Morechips/yuntong-smart-glasses/3D打印文件/ArcMask_后枕托穿带修正_20261101/README.md

# 后枕托穿带修正：单件补打

> 提交版只附完成后的结构模型、打印文件、图示和说明；本目录原说明中提及的生成脚本与参数文件不随包附带。

2026-11-01后续更正：用户看过候选后要求继续建；本轮沿用25mm带宽/单层≤2.5mm的设计假设，输出**单盘一件3MF并完成离线切片**，不再停在仅候选图阶段。带厚没有新增实测，真实穿带/承力仍待试装；不把用户“继续建”当作尺寸实测或适配通过。

## 本次补打文件

- [单盘一件3MF（A1 / 0.4 / PETG）](ArcMask_Rear_R01_A1_PETG_1part.3mf)
- [本体和清支撑辨认图](images/print_cleanup.png)
- [实际切片支撑路径](images/sliced_supports.png)、[首层路径](images/first_layer.png)
- [最终3MF/G-code核验](qa/project_verification.json)、[两种支撑比较](qa/support_comparison.json)

预测 **2小时1分10秒 / 20.89g**，含支撑/裙边。仅R01后枕托，不含旧件、其他壳体、织带或电池盒。实体落床包络119×51×20mm，安装柱朝上；A1/0.4喷嘴、PETG、0.2层高、4墙、20%陀螺、普通自动贴合支撑、上下间隙0.2、外裙边4mm。温度沿用既有Generic PETG档255℃/80℃、体积流量8mm³/s，未替用户发送打印。

同几何/姿态下，树状版本预测2:29:01/21.28g，普通贴合2:01:10/20.89g，选后者。两版均保留在`qa/`比较目录；支撑哪版更易拆没有实测，不能从估时或路径图宣称拆支撑效果更好。最终3MF与当前STL顶点/三角面匹配、无缩放、单盘一件无漏切/越床，实际支撑与界面路径存在。只有传统延时摄影不支持提示，不是模型悬空警告。

## 打完怎么清理

1. 冷却后取件，先去外裙边。
2. 将底部生成支撑分小块剪开清理，靠近连接处时用钳口接近界面，避免整片撬动薄弧面或以安装柱作杠杆。
3. 清空左右带槽和中间顶带槽，保留槽框。**两根电池安装柱、上下宽连接根和全部槽框都是本体**，见辨认图。
4. 先穿自由带尾并回折，再装原电池盒；孔位未改。先小幅试拉观察连接根/柱根，再试装带软垫。实际织带缝边、硬扣、折弯和粘合长度仍需实配，不强塞。

用户实物显示后枕托长带口紧靠电池安装柱，带子穿出后无法转弯。源码确认原槽内侧X44.5与柱外缘X44.2只有0.3mm；之前孔贯通检查遗漏穿出、转弯和回折路径。这是设计遗漏，不要求靠硬塞或剪安装柱解决。此前“旧佩戴件继续复用”的建议须撤回后枕托这一项。

## 查看

- [新旧局部对比](images/rear_old_new.png)
- [穿带与电池位置](images/rear_threading.png)
- [离线旋转模型](rear_strap_viewer.html)：拖动旋转，图例切换电池盒和橙色织带参考。
- [修正后枕托STEP](step_parts/R01_rear_cradle_clear_strap.step)
- [落床STL](stl_print/R01_rear_cradle_clear_strap.stl)：仅枕托一件，无织带/电池盒；与最终3MF匹配。
- [29项数字检查及参数](qa/validation.json)

## 改动与穿法

| 项目 | 旧版 | 修正候选 |
|---|---:|---:|
| 左右带耳中心X | ±48 | ±56mm |
| 槽净开口，带宽×厚度方向 | 25.8×3.6 | 26.5×6.0mm |
| 槽内侧至柱外缘，中心高度处 | 0.3 | 8.3mm |
| 含耳总宽 | 103 | 119mm |
| 主贴头曲面宽/高/球面半径 | 92/38/R120 | 保留 |
| 电池安装轴 | X±40/Z8，座面Y222 | 保留 |

两个耳各向外8mm，上下连接梁各3.75mm高、沿Y为12mm深，连到原弧面后按原软垫包络裁切；四根部均有正体积重叠。梁位于织带上下，不穿过进带通道。电池盒、前部壳体、B分体内架和旧文件不改。

自由带尾从外侧沿X穿过长槽，从槽内侧出来后在柱外侧的新空区向前转弯，围过带耳前侧横条，向原侧带方向回折粘合。左右镜像。橙色为织带占用空间，不是打印件。按25mm宽、单层最大2.5mm、中心线转弯半径3.5mm建立；半径是检查候选，不是已验证的织带弯折要求。6mm净槽不表示硬扣、缝边或整个闭合环均能穿过。

## 检查边界

29项数字检查包括：原几何重建对已交付STEP，新件单实体/有效、STEP往返、STL闭合与候选落床，左右完整U形包络及连续直线穿入通道对枕托/原电池盒的避让，原孔/工具通路、主接触壳与软垫包络保留、四根部实体重叠、旧源SHA不变。

**绑带已到，最厚缝边/魔术贴单层厚度尚未实测反馈。** 之前1.6mm及本轮2.5mm均为设计假设，已单独询问这一项，不需要重测其他元件。实际带宽、缝边/硬扣通过、折弯和粘合长度、支撑拆除/强度、软垫及佩戴均待验；`all_checks_passed=false`。

此前“暂不发布带G-code的3MF、等待厚度”的停点由本轮用户要求继续建及上述单件工程取代；实测待验并未关闭。仅该后枕托一件补打，原件不建议剪柱或削薄承力根部。不涉及打印提交或电子设备操作。

几何重建：`build_rear.py`（项目CadQuery环境）；图及查看器：`render_rear.py` / `render_cleanup.py`；工程打包/离线切片/核验：`prepare_print.py` / `slice_print.py` / `verify_print.py`；交付和记录核对：`finish_gate.py`。参数和旧源SHA在检查记录，用户实物反馈摘要在`reference/user_feedback.json`；聊天附件的原临时路径已无法读取，未伪称保存原照片。
