Morechips/yuntong-smart-glasses/3D打印文件/RDKX5_B3_v0_1_分仓计算盒_20261102/README.md

# RDK X5 B3 v0.1 · 一体双仓计算盒

> 提交版只附完成后的结构模型、打印文件、图示和说明；本目录原说明中提及的生成脚本与参数文件不随包附带。

用户于2026-11-02确认五金规格并授权建模。本版为实际可编辑CAD与单件打印网格，沿用X5上层/P23C下层、旁侧电池分仓、同一底座，DC和USB从盒外连接；未发送打印、未接线、未操作开发板。

## 查看与文件

- 新增带标注整体图与逐层分解图（原工作区参考，本包未收录），采用当前M3套筒＋M2贯穿配置；仅改变展示，制造文件不变。
- **打印入口：[A1/PETG单盘九件3MF](B3_v01_A1_PETG_9件.3mf)**。对应已接受的M3套筒临时装法，也兼容M2.5正式铜柱；两种装法复用这九件，无需热熔胶承担固定。0.20mm层高、4道墙、20%陀螺填充、按层打印、关闭自动支撑；此项由`qa/print_project_verification.json`记录最终切片与摆盘核对。
- 实际离线切片预测 **13小时7分52秒、170.46g**，一盘九件均切出，无越床或支撑路径，保留3mm物件间距；只有延时摄影兼容提示。打印时间取决于实际机器/耗材配置，这不是实打印计时。未发送打印。
- [可旋转三维模型](B3_模型查看.html)：自包含离线HTML，浏览器打开；可组装/开盖/拆分、查看底面和五金。深色/绿色/棕色仅区分零件，实际可都用现有PETG。
- [整机与内部图](images/01_整体与内部.png)、[拆分与安装顺序](images/02_拆分与顺序.png)、[背部绑带桥](images/03_背部绑带.png)、[九件认件图](images/04_九件认件.png)。均由本CAD直接渲染，非AI效果图。
- [整机STEP](B3_v01_assembly.step)：包括打印件、参考电子件和五金，**不能把整个STEP当作一个打印件**。
- [单件STL目录](stl/)已按打印方向平放，单位mm；[单件STEP目录](step/)为装配坐标下的可编辑实体。
- 参数（建模生成资料仅留原工程，本包未收录）、CAD源代码（建模生成资料仅留原工程，本包未收录）、[几何检查](qa/geometry_checks.json)、[单件清单](qa/parts_manifest.json)。

## 尺寸与结构

- 主盒体 **98×146×55mm**。九件打印结构含背桥包络约 **101×146×68mm**；正式版含螺丝头的整体约 **105×149.5×71.5mm**，外接插头/线弯和贴身软垫另计。尺寸由[交付核验](qa/delivery_checks.json)读取实体计算。
- 计算仓与电池仓共用2.4mm承重底座，中间双壁和7mm空气通路；侧壁竖槽用于通风，不作为已验证隔热或散热的结论。
- X5按官网未缩放STEP定位。安装孔中心直接取官方STEP的约3.5052/61.5052及3.4982/52.4948，孔距58×约49、孔径Ø2.5。
- P23C按65×56×1.5、孔距58×49/Ø3.1、正面11.3/背面3.4mm的保守高度区固定。插座块位置仅用于识别，两端采用宽服务窗，尚无P23C精确ECAD；不能据此宣称全部插拔已实测通过。
- 上层横框从板上方用4个M2.5×8铜柱固定X5，下方不再堆一层完整厚底板。模块先在桌上预装，再由4颗M3×10装入底座。计算盖用3颗M3，第四角由侧板上沿支承，避开横框紧固区。
- 电池实体67.4×55.2×43.5，底部留1.6mm软垫，盒体/底座承重；小挡条做侧向防滑，不能靠盖板和弹性带挤压电芯。最大高度之外还有约5mm上方软线余量；充电母头在电池侧边口袋，开盖取出。
- 20×20×7mm散热片及0.5mm导热层是空间预留，型号未选定。当前无风扇，是否够散热要实际负载装机测温。

## 五金实际用量

**M2.5铜柱未到时，用户已接受的临时方案**：用 **M3×8mm内孔贯通的双通铜柱8个＋M2×16盘头/圆柱头螺丝8颗＋M2螺母8个（对边4、厚约1.6）**。铜柱仅作间隔套，M2杆自由穿过，再由螺母锁紧；保留孔环绝缘垫。柱身8mm、对边≤5.5mm，不用M3公母柱的外螺纹穿X5孔，不扩Ø2.5原孔，也不用M2去啮合M3螺纹。需要上下对孔后轻锁，不能压PCB弯曲。实际柱长/外径、是否贯通仍以手头件为准；若不同不能直接套用。

临时方案不改九个打印件，396项数字避让已过，见[临时五金核对](qa/temporary_hardware_checks.json)。贯穿后的下层螺丝露出螺母约1.4mm，上层约1.0mm，已检查对应空间；仍需实配。原来M2.5短螺丝/铜柱只用于下面正式方案，临时方案用M2长螺丝和M2螺母替代它们。

| 项目 | 本模型用量 | 前述预备数量 |
|---|---:|---:|
| M2.5×8双通六角铜柱，对边5mm | 8 | 10 |
| M2.5×5内六角圆柱头螺丝 | 16 | 20 |
| M2.5尼龙平垫，厚0.5，外径按5.5建模 | 24 | 30 |
| M3×10内六角圆柱头螺丝 | 19 | 20 |
| M3×16同款螺丝 | 4 | 8 |
| M3普通六角螺母，对边5.5、厚2.4 | 23 | 30 |
| M3平垫，厚0.5 | 23 | 30 |

M3平垫统一按外径7mm、厚0.5mm建模，背桥头部凹位Ø8mm。螺丝长度都从头下量；M2.5/M3内六角扳手分别为2.0/2.5mm。少量细扎带或现有线绳可用于止拉，软垫沿用现有材料；没有要求购买热熔螺母或新铰链。

## 安装顺序

**当前临时装法请先看[简明图解](安装简明说明.md)**，按M2×16贯穿/顶端M2螺母锁紧；下面第2～3步为M2.5正式铜柱的装法，不能照搬成M2啮合M3。

1. 清理短孔/螺母位。先在空底座预放23颗M3普通螺母；侧板关闭后部分入口会被挡住。各孔只轻试，不用长螺丝顶底扩孔。
2. 下层：4个8mm铜柱先用4颗M2.5×5从底座背面固定，头与垫片放进凹位；再放尼龙垫、P23C、尼龙垫，用另4颗M2.5×5固定。正面大电容朝上。
3. 桌上预装上层模块：X5上表面的孔环放尼龙垫、铜柱，板下放尼龙垫和4颗M2.5×5向上拧入；横框放在铜柱上端，用另4颗M2.5×5固定。只接触安装孔周围硬区，不压元件/焊点。
4. 上层模块从顶部整体落入，用4颗M3×10固定横框。下层插头、上层SD/排线、螺丝工具操作均在盖板关闭前试摆。
5. 装左服务板4颗、右服务板2颗、前服务板2颗M3×10。左侧宽窗对应P23C输入与X5 HDMI/音频，右侧对应P23C双C和X5 USB-A/RJ45，前侧对应供电/设备C/调试/SD及排线服务。
6. 电池底垫薄软垫后放入，输出线由左侧开放U槽侧放进去，用现有线绳/细扎带轻束止拉；母头放侧边口袋，软线松弯收纳，盖合前检查不夹线。
7. 计算盖3颗、电池盖4颗M3×10最后装。外部DC公头接P23C，供电USB从P23C到X5电源C口；按实物丝印识别，不把设备C或HDMI当电源口。本模型不验收电源板双口总电流/供电兼容。
8. 两个U形背桥分别拆下、放入50mm带子，再用4颗M3×16装回。横向/纵向通道净宽54、净高6mm；尾端不必穿闭口。允许沿带长调节，实际承载、滑动和防摆需试戴；不宣称6mm通道能把4mm叠层摩擦夹死。

## 打印准备

- 现有PETG、0.4mm喷嘴可先用0.20mm层高、4道墙、4～5层顶底、15～20%填充。温度/流量沿用实验室对这卷料已跑通的预设。
- STL已放好朝向：底座平底贴板、开口朝上；三侧板的宽平面贴板；盖板/横框平放；背桥宽底朝下，两端脚朝上。**背桥与底座分体，因此无需把整个底板悬空架在四个脚上打印。**
- 当前结构以免支撑方向设计，螺母位只有短桥接。切片后仍需逐层确认，不能把CAD检查当成已完成切片；勿直接对整机STEP自动支撑打印。
- 用户后续要求简单核对并给3MF，已增加上述单盘工程。切片结果/时间以`qa/print_project_verification.json`为准，未提交打印；实际接头插拔和带子仍待试装。需要的局部适配改动只改对应侧板/横框，不重打整套。

## 核验边界与来源

数字核验包括独立打印件间、官方X5全706实体、P23C保守两面高度、电池实测外廓，以及五金/面板插头通道和上层模块竖向装入位置。实际插座外形、线根、手指可达性、螺纹咬合、PETG层间强度、带子摩擦与长期温升仍需实物核对；数字检查不是安全/承载或热性能证明。

官方来源：[下载入口](https://developer.d-robotics.cc/rdk_x_doc/Quick_start/download?p=RDK+X5&v=3.5.0)、[X5 STEP](https://archive.d-robotics.cc/downloads/hardware/rdk_x5/RDK_X5_LPDDR4_4266MHz_V1P0_pcb.stp)、[官方规格书](https://archive.d-robotics.cc/downloads/hardware/rdk_x5/d_robotics_rdk_x5_zh_v1_1.pdf)。本地原件在前期方案目录`refs/`，原始输入见实测记录（原工作区参考，本包未收录）。
