Morechips/yuntong-smart-glasses/docs/STATUS.md

# 实现状态与验证范围

整理日期：2026-11-04。以下历史实机结果来自原工程记录，本次整理没有重新操作设备。

| 内容 | 当前状态 |
|---|---|
| 地面模型 → X5 → 电脑决策 → ESP 声振 | 已在开发场景完成真实闭环，用户确认能听到 / 感到 |
| 持续演示窗口、断流清旧状态、原地址重连 | 已有软件检查与短时实机记录；未完成数小时佩戴验收 |
| PC ONNX 与 X5 BIN | 同 32 张开发图，实板类别与量化模拟像素差为 0 |
| 原始训练数据 | 六张训练图、两张同走廊开发探针；标签为粗监督 |
| 头戴结构 | 用户反馈已制作装配完成；局部强度、触感串振、热与长期舒适性待验 |
| RDK X5 B3 计算盒 | CAD / STEP / STL / 单盘 3MF 已有数字检查，实物插拔 / 承载 / 温升待验 |
| 地面＋盲道双模型联调 | 已在真实图像流完成连续运行，障碍语音与盲道振动均有回执；仍有秒级空档，佩戴左右和身体航向未验 |
| 完整导航 / 路径规划 / 测距 / 视觉 IMU 融合 | 未在当前入口实现 |

## 已有记录及其口径

| 日期与范围 | 结果 | 不能推导的结论 |
|---|---|---|
| 11-01 真实视觉声振闭环，30 秒 | 435 结果 / 561 接收，3 句音量 55 语音、3 次 500ms 短振；接收至决策 P95 98.061ms | 非曝光到反馈延迟，非独立准确率 |
| 11-01 静音持续运行，150 秒 | 2703 结果 / 2712 接收，最近 2048 结果 P95 63ms，正常结束和清理 | 全部 UNKNOWN，只验证运行与退出，不是障碍识别验收 |
| 11-02 双模型固定图，90 秒 | 1230 地面 / 238 盲道结果，地面 RPC＋决策 P95 80.66ms | 缓存图不含真实图传，不等于稳定实流 |
| 11-02 双模型真实流，60 秒 | 702 接收 / 667 地面 / 139 盲道，地面 P95 78ms；5 次 >500ms 空档，最长 1531ms | **连续性未通过**；镜头天花板、全 UNKNOWN，不验识别 |
| 11-04 双模型连续联调，182 秒 | 1084 帧接收 / 1033 地面结果 / 盲道 CONFIRMED 33，语音确认 29 次、振动确认 2 次，接收至结果 P95 96ms | 46 次 >500ms 空档、最长 3219ms；非佩戴行走验收 |

纯图传也出现超时 / 重连，部分源帧年龄保守下界超过 500ms。接收后时效不能代替源帧新鲜度，根因未定；这项问题在提交整理中没有修复。

X5 曾出现 MMC / 文件读取 I/O 错误。用户重启后暂未复现、挂载可写且 ext4 错误计数为零；不能据此称存储问题已解决。

## 双模型联调源码

`benchmarks/ground_tactile_joint_20261102/` 为地面障碍与盲道双模型联调源码，含软件测试和运行记录说明。分工为地面结果驱动障碍方位语音、盲道结果驱动图像偏位触觉。三帧确认、换源清除、障碍优先、居中不振已随联调路径实现；佩戴左右、身体航向和真实走直线验证仍未完成。运行记录中的 `runs/`、`qa/` 目录不随本包提供，相关链接指向原工作区。

本次包不附带外部盲道权重、外部校准照片和原工作区冻结清单。`paths.py` 已改为校验本包的主链路文件清单。需要自行准备合法可用的以下文件后才能尝试候选：

```text
benchmarks/blindpath-guideTWSI-x5-20260911/model/yolo11n_tactile.onnx
benchmarks/blindpath-guideTWSI-x5-20260911/model/yolo11n_tactile_bayese_640x640_nv12.bin
benchmarks/blindpath-guideTWSI-x5-20260911/calibration/teaser_0206.jpg
```

BIN 预期 SHA256：`4c5150ce17c1e09264ffbadc20a0af84733be8c5edfbc579aded69f4f47b7439`。来源与授权需要结合原项目和模型链核对，不能用本包的自有代码说明覆盖。

## 本次整理的核验

`submission/validation.json` 记录本包实际执行的文件哈希 / 路径 / JSON / Python 语法 / 文档链接 / 隐私规则检查、软件测试、真实 PC ONNX 离线推理和结构文件检查。模拟流测试只使用本机回环服务，不是 ESP 实测。

本次主链路 44 项、采集工具 13 项软件测试通过；初次回环网络与临时目录受沙箱限制，随后在允许本机回环、使用工作区临时目录的环境中复测通过。32 张开发图真实 PC ONNX 推理完成。结构文件检查覆盖 43 个 STL、49 个 STEP 文件头、6 个 3MF 容器 / 模型 XML；STL 在内存合并重合顶点后检查闭合、绕向与正体积，没有改写网格。

没有新增硬件准确率、曝光到反馈时延、长时续航、结构承载或散热结论。各建模子目录的历史检查只属于原版数字几何 / 切片验证，不能替代试装。
