Morechips/yuntong-smart-glasses/3D打印文件/ArcMask_v0_5_小振动盒与喇叭修正_20261101/FASTENERS.md

# 本批8件使用的紧固件

以下只算本次两只振动盒和一只扬声器盒，不覆盖前罩/B内架的既有紧固件。

| 用途 | 螺丝 | 数量 | 配套螺母 |
|---|---|---:|---|
| 两只振动盒盖 | M2×10，内六角圆柱头优先 | 4 | 普通M2六角螺母4颗 |
| 扬声器盒盖 | M2×10，内六角圆柱头优先 | 2 | 普通M2六角螺母2颗 |
| 两块振动PCB | 现有M3十字平底盘头；头下杆长按5.5mm，头径5、头高约1.2mm | 4 | 普通M3六角螺母4颗 |
| **合计** | **M2×10六颗；现有M3盘头四颗** | **10** | **M2六颗；M3四颗** |

用户现有6颗M3，使用4颗后剩2颗备用。平底盘头已由用户确认，不采用沉头锥面承托。原答复“ 不含杆长 ”在上下文中按“不含螺丝头的杆长5.5mm”解释；本版螺丝几何按该长度留余量。

M2螺母按普通六角对边4.0、厚1.6mm；M3按对边5.5、厚2.4mm。不要将加高防松螺母或热熔螺母塞入这些六角位。M2内六角圆柱头常用1.5mm内六角扳手；M3用与实际十字槽贴合的批头，不根据头径猜槽号。

M2×10已经落实在新盖子与盲孔内，螺杆检查上限10.3mm。M2头部按Ø4.2×2.0包络避让。现有M3按杆长上限5.8、头部Ø5.3×1.5包络；头藏在底部Ø5.8凹位内，不作为贴头凸点。PCB上侧普通M3螺母由小打印定位条防转。M3平底凹位是承头座，不是让螺纹咬进PETG的自攻孔。

先将螺母装入定位条/盖子，再装螺丝。若打印残丝让螺母放不进去，先清理；两边交替拧到不松动即可，不能继续强拧使PCB弯曲或撑裂PETG。当前未给出实测扭矩或抗松动寿命。

**更正此前长度建议：** 本版已按现有M2×10和M3盘头适配；先前草稿的M2×6/M3×4不再是本批采购清单。M2×10不能直接套用旧6件草稿或旧扬声器盒。

标准尺寸参考为制造商[ISO4762圆柱头螺丝表](https://itafasteners.com/products-socket-head-cap-screws.php)及[ISO4032普通六角螺母表](https://www.jcfasteners.com/wp-content/uploads/2019/02/ISO-4032-Hex-Nut-B4C32-SS-304.pdf)。用户M3低盘头的尺寸来自用户实测，不套用M3内六角圆柱头尺寸。
