Morechips/yuntong-smart-glasses/3D打印文件/README.md

# 结构模型索引

> 提交版只附完成后的结构模型、打印文件、图示和说明；本目录原说明中提及的生成脚本与参数文件不随包附带。

先阅读 [当前组合和装配说明](../docs/MECHANICAL.md)。子目录含原版制造文件和历史说明，旧电子内架 / 相机夹 / 外围盒有替换关系，不能整套混打。

- [ArcMask_v0_3_1_补打加固_20261031](ArcMask_v0_3_1_补打加固_20261031/)
- [ArcMask_v0_4_B分体内架_20261031](ArcMask_v0_4_B分体内架_20261031/)
- [ArcMask_v0_5_小振动盒与喇叭修正_20261101](ArcMask_v0_5_小振动盒与喇叭修正_20261101/)
- [ArcMask_后枕托穿带修正_20261101](ArcMask_后枕托穿带修正_20261101/)
- [RDKX5_B3_v0_1_分仓计算盒_20261102](RDKX5_B3_v0_1_分仓计算盒_20261102/)
