Morechips/yuntong-smart-glasses/3D打印文件/ArcMask_v0_3_1_补打加固_20261031/README.md

# v0.3.1：只补打破损结构的加固版

> 提交版只附完成后的结构模型、打印文件、图示和说明；本目录原说明中提及的生成脚本与参数文件不随包附带。

> **实装更正（2026-10-31后续）：用户确认复用的电子内架与主板四孔失配。下文“15件可复用”仅是当时几何未变结论，不代表实物适配；电子内架现需实测修订，不能强装或重打同一错误件。见主板失配记录（原工作区参考，本包未收录）。**

用户已定位两根脱落柱来自检修窗边，覆盖此前“来源待确认”的评估停点；同时授权修改此前损坏的斜脚与薄佩戴架。本版独立保存，旧CAD/STL/3MF不覆盖，没有发送打印任务。

## 直接用这些文件

- [仅补打5件、两盘A1/PETG工程](ArcMask_v031_A1_PETG_仅补打5件_两盘.3mf)。**这不是原整套四盘工程，不要再从旧3MF重打破损件。**
- [实际改动和连接图](previews/06_补打改动与连接说明.png)、[完整总装图](previews/01_总装外观.png)、[离线旋转模型](ArcMask_模型查看.html)。
- [分件STL](stl_fit_parts)、[分件STEP](step_parts)、[打印件总装STEP](ArcMask_v0_3_1_printed.step)、[含参考总装STEP](ArcMask_v0_3_1_with_references.step)。这些目录含完整20打印件，实际补打仅下面5件；软垫/线带/电子占位不打印。
- [详细装配和拆支撑说明](ASSEMBLY.md)、参数（建模生成资料仅留原工程，本包未收录）。

## 补打清单与时间

| 盘 | 零件 | 本机切片预测 | 用料含支撑/裙边 |
|---|---|---:|---:|
| 1 | 加固结构外圈、新小检修盖、左连接片、右连接片 | 5:13:22 | 57.89g |
| 2 | 加强后的额托/脸垫架 | 5:02:37 | 41.41g |
| 合计 | 5件 | 10:15:59 | 99.30g |

其余15件打印几何核对不变，可复用已打好的平前盖、平后隔板、电子内架、相机/IMU固定件、后枕托、电池盒、振动舱及2209喇叭壳。若旧件自身有损伤仍需单独判断，数字复用核对不是实物合格证明。

两张连接片完全平放，背面两个短方台朝上；它们和小盖关闭支撑。外圈和曲面架仍用自动树状支撑，不能整盘统一关闭。切片采用原A1/0.4/PETG/纹理PEI、255℃喷嘴/80℃床、0.2层高、20%陀螺；这批改为4墙。最终时间/用料是预测，不代表实打验收。

## 怎么改的

1. **窗边两柱**：改成8mm宽、6.8mm高的连续螺母承台，接到未挖沉台的完整顶壁；不再仅依赖0.2mm薄连接边。承台与内架保留0.4mm名义退让。检修开口仍26×14，支座螺丝孔距32→36，所以配套小盖改为45.6×19.6；旧37.6宽小盖不能混用。这里仍有螺母孔，不是取消固定功能。
2. **四斜脚**：从曲面架上取消，拆成左右两张3mm平板连接片，背面仅有2.5mm高的短方垫台；不再打印长细圆杆和小圆耳。原外圈四接口X±73/Z±26/Y40、后头座Y43不变。
3. **薄曲面**：脸框1.6→3.0、额托2.2→3.0；向非贴肤侧加料，原软垫接触曲率和位置保持。额/脸之间两根Ø4圆桥筋换成10mm宽连接肋，额托通风孔缩为两个较小孔、顶带锚点加宽。鼻部开口保留，不用硬横杆跨鼻梁。

原壳体含耳外廓178.4×70、含安装柱深40不增加；相机、主板、弯针IMU、原电池/两个完整振动模块及2209喇叭不换，不要求重接全部线束。加固增加塑料和4套连接紧固件，不宣称减重或已证明足够强。

## 新增紧固件与装配

新增连接片到架体共4颗M2螺丝、4颗M2螺母；M2×10是名义试配候选，垫片/实际头型与螺钉尖端余量要实物核对。原外圈四颗连接螺丝和小盖两套螺丝/螺母可先试用原件，不能沿用过长螺钉硬顶。

**先把左右连接片安装到曲面架，再将整个佩戴模块装到外圈。** 内侧一列孔用于新架体，外侧一列孔才对应原四个外圈孔；螺丝装入方向不同，见[装配说明](ASSEMBLY.md)。

## 检查结果与限制

- [CAD检查](qa/validation.json)：267项几何检查通过、10物理项pending，all_checks_passed=false。完整20打印件有效/闭合、STEP回读、所建刚性元件/软垫无穿入。
- [独立改版核对](qa/repair_geometry_verification.json)：旧34文件哈希不变，15件打印几何/硬件包络/软垫位置不变，外壳外廓不增加。
- [柱根实体检查](qa/reinforced_root_verification.json)：承台接缝及完整顶壁连接区域的实体见证填充率均100%；验证不是只靠旧0.2薄边连接。**这是几何见证，不是载荷或实物强度测试。**
- [两盘3MF/G-code检查](qa/verification.json)：5件无漏切、4/1分盘、源网格刚性变换、逐件配置、实际挤出床界检查通过；预览/首层已目视审阅，未在用户GUI复核告警或逐层全承接。
- [离线查看器逻辑](previews/viewer_logic_checks.json)检查通过，浏览器WebGL画面未实测；图片来自真实CAD，不是AI外观图。
- 开发第一轮检出承台/内架76.8mm³及连接片/宽肋各7mm³干涉，缩短承台、内移宽肋后重跑关闭，没有放宽阈值。

先清支撑、空件试螺丝/螺母和闭合，再装电子件/软垫。损坏旧架不靠胶粘继续承重；新件的拆支撑、反复紧固、压力、佩戴、温升和动态固定仍需实物检查。本轮未操作打印机、ESP/RDK、固件、RDK视觉模型或电气执行器。

回退/追溯：原v0.3 A（原工作区参考，本包未收录）、前轮故障评估（原工作区参考，本包未收录）。
