Morechips/yuntong-smart-glasses/3D打印文件/ArcMask_v0_5_小振动盒与喇叭修正_20261101/annotated_structure/README.md

# 当前保留版v0.5结构标注图

> 提交版只附完成后的结构模型、打印文件、图示和说明；本目录原说明中提及的生成脚本与参数文件不随包附带。

直接使用已交付8件主盘对应的`qa/meshes.json`渲染，没有使用已停止的补边/斜筋候选，没有重建CAD或更改打印方向。

- [结构拆解与认件](01_当前版结构拆解与认件.png)：每只振动盒的H01/H02/H03，2209盒的S01/S02，紧固、出线和本体辨认。
- [安装朝向与底部螺丝](02_安装朝向与底部螺丝.png)：织带/头侧、底面M3凹位、扬声器出音面及安装顺序。
- [可编辑标注源](当前版结构标注.drawio)：两个原生draw.io页面，真实CAD渲染作为嵌入图，文字/编号/引线可编辑；PNG也附带相同mxfile元数据。
- [源文件核对](manifest.json)：原v0.5模型、参数、网格、主盘3MF哈希；未改制造文件。

拆解图将盖子、定位条和元件上提，间隔不表示实际装配间隙；灰色电子/螺丝为外廓参考，不是详细ECAD。为避免误拆，生成支撑未画，桥/孔柱/定位条均为需要保留的本体。两张图已经目视检查，无文字重叠或裁切；实际清支撑、接触、声音、触感和强度仍待实装。

采用既有CAD渲染器和同源draw.io图元/Pillow输出；未依赖本机不可用的draw.io桌面导出，不借AI图片重绘结构。
