Morechips/yuntong-smart-glasses/RIGHTS.md

# 本项目授权说明

本次整理未收到团队指定开源许可证的指示，因此没有为自有代码、模型和结构设计擅自选择 MIT、Apache、GPL 或其他许可证。

源码可见不自动确定其再分发 / 商用权限；具体授权由权利人另行明确。第三方组件和材料仍按各自的来源及许可证处理，见 `THIRD_PARTY_NOTICES.md`。

这是项目提交整理说明，不是权属证明。团队署名、贡献者和许可证可在正式发布前按真实情况补充。
