Morechips/yuntong-smart-glasses/3D打印文件/ArcMask_v0_3_1_补打加固_20261031/previews/02_结构尺寸.png

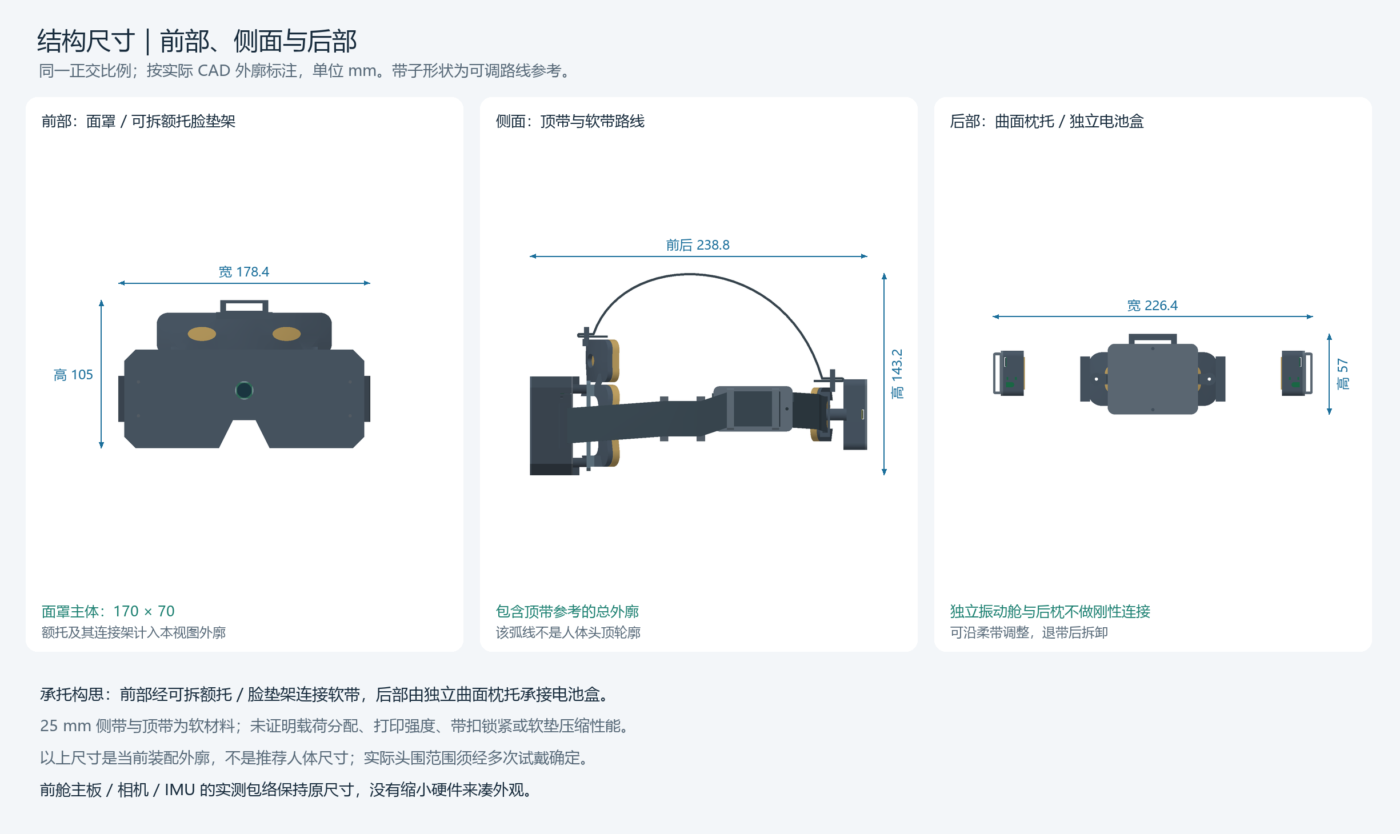
3D打印文件/ArcMask_v0_3_1_补打加固_20261031/previews/02_结构尺寸.png
