Morechips/yuntong-smart-glasses/3D打印文件/ArcMask_v0_3_1_补打加固_20261031/previews/03_内部布局.png

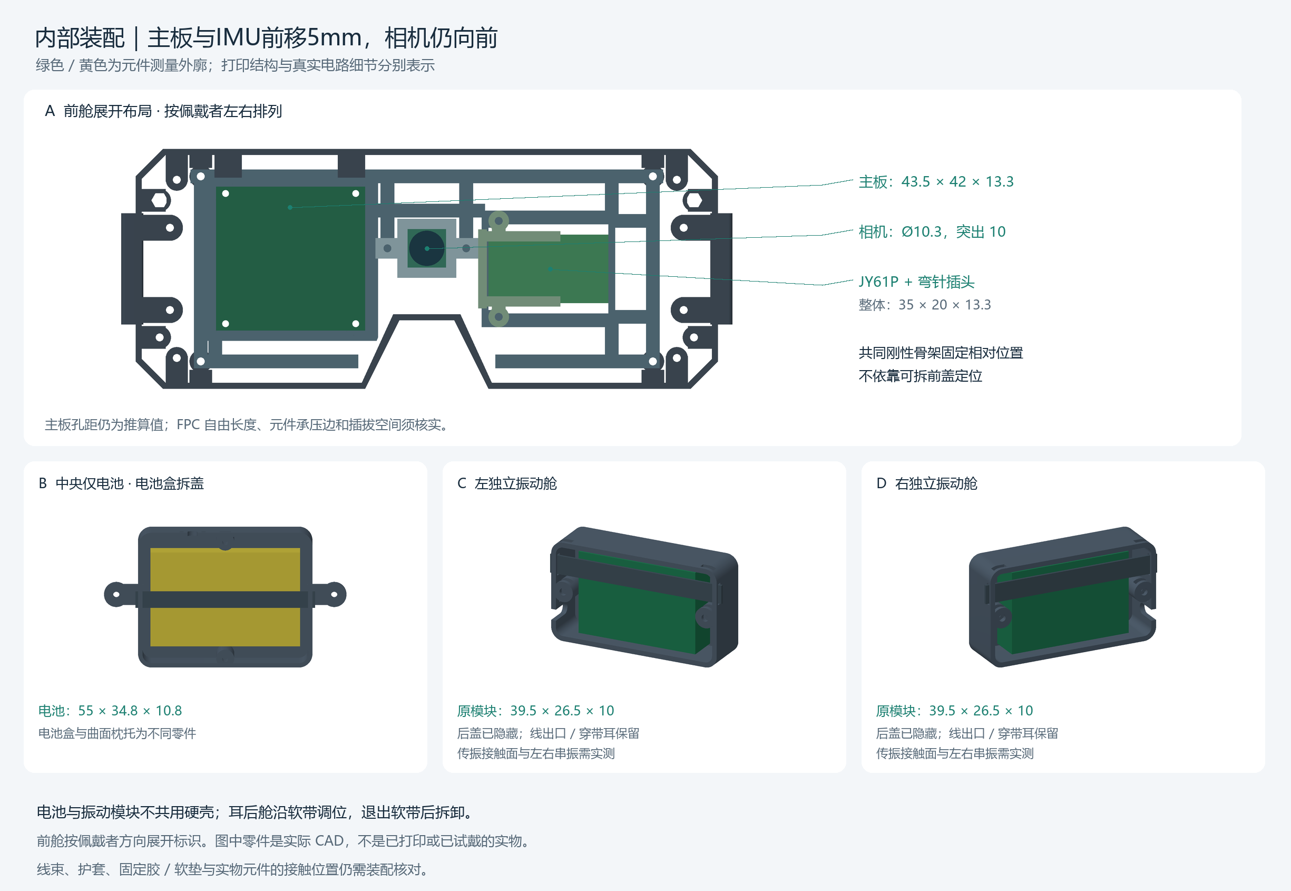
3D打印文件/ArcMask_v0_3_1_补打加固_20261031/previews/03_内部布局.png
