Morechips/yuntong-smart-glasses/3D打印文件/ArcMask_v0_4_B分体内架_20261031/images/03_fasteners_camera_IMU.png

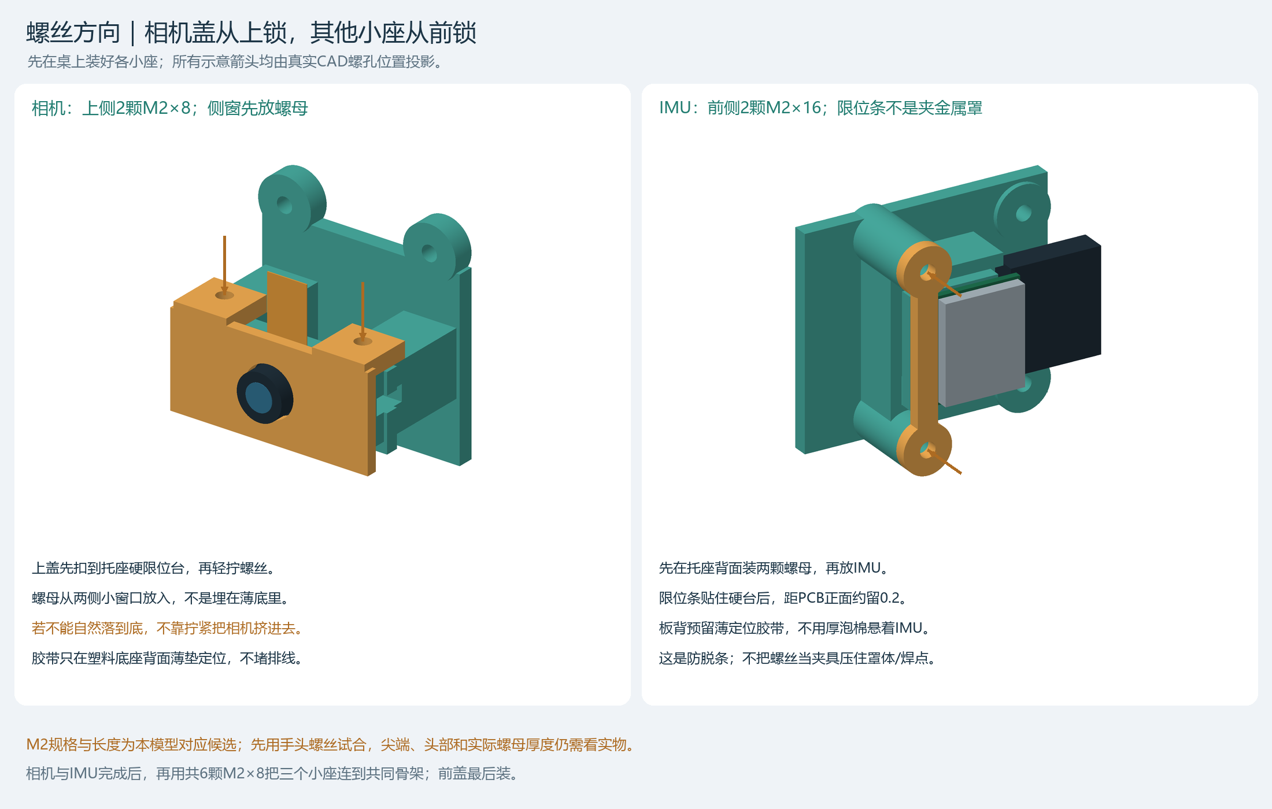
3D打印文件/ArcMask_v0_4_B分体内架_20261031/images/03_fasteners_camera_IMU.png
