Morechips/yuntong-smart-glasses/3D打印文件/ArcMask_v0_4_B分体内架_20261031/images/first_layer.png

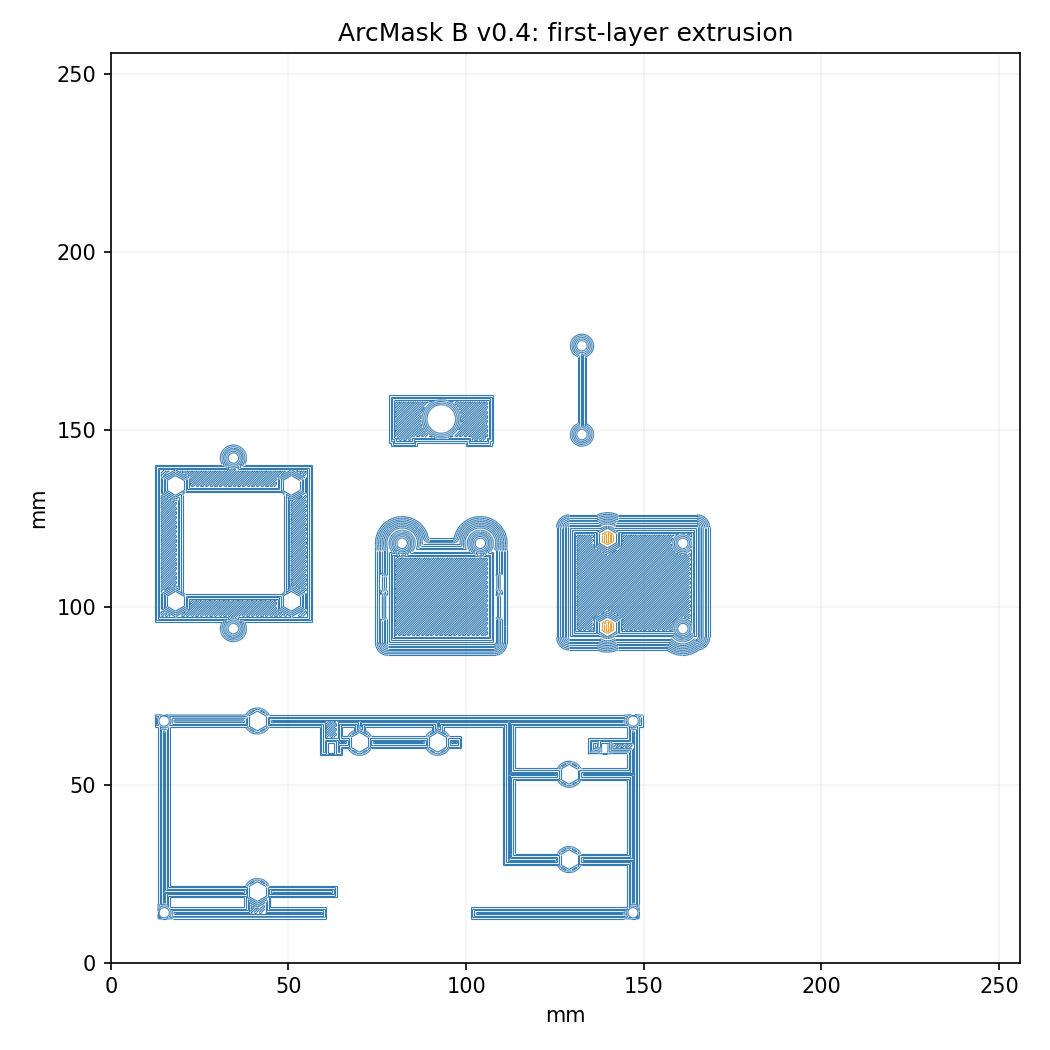
3D打印文件/ArcMask_v0_4_B分体内架_20261031/images/first_layer.png
