Morechips/yuntong-smart-glasses/3D打印文件/ArcMask_v0_4_B分体内架_20261031/images/top_1.png

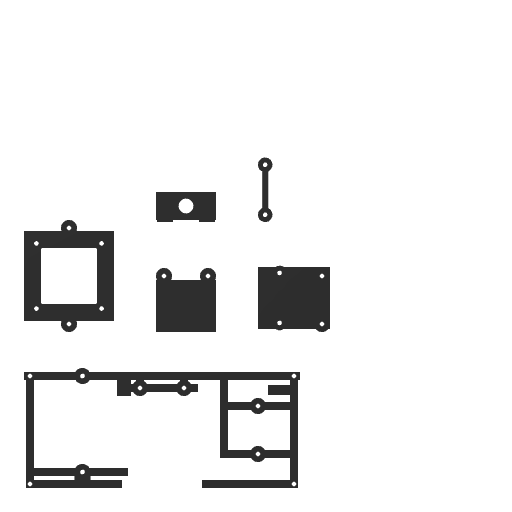
3D打印文件/ArcMask_v0_4_B分体内架_20261031/images/top_1.png
