Morechips/yuntong-smart-glasses/3D打印文件/ArcMask_v0_5_小振动盒与喇叭修正_20261101/images/optional_backplate_first_layer.png

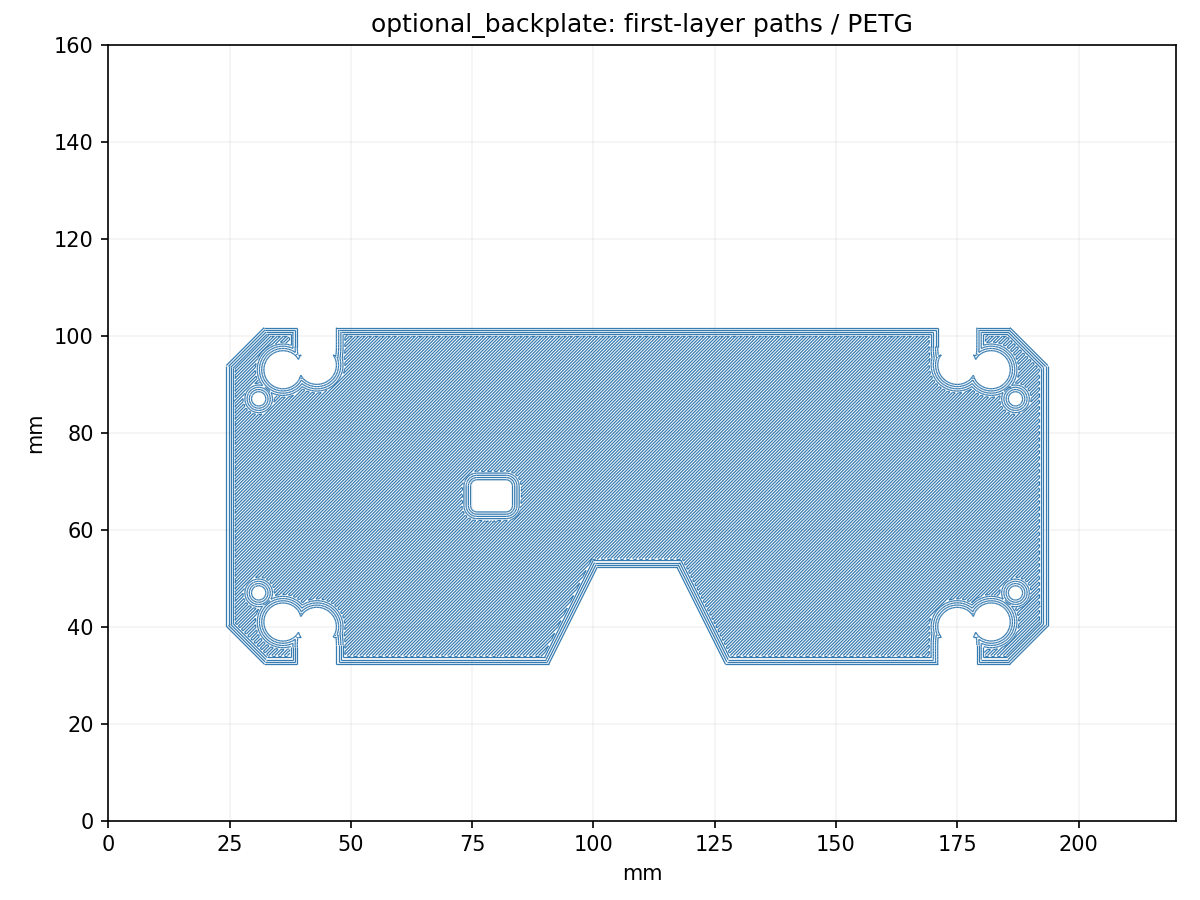
3D打印文件/ArcMask_v0_5_小振动盒与喇叭修正_20261101/images/optional_backplate_first_layer.png
