Morechips/yuntong-smart-glasses/3D打印文件/ArcMask_后枕托穿带修正_20261101/images/plate_1.png

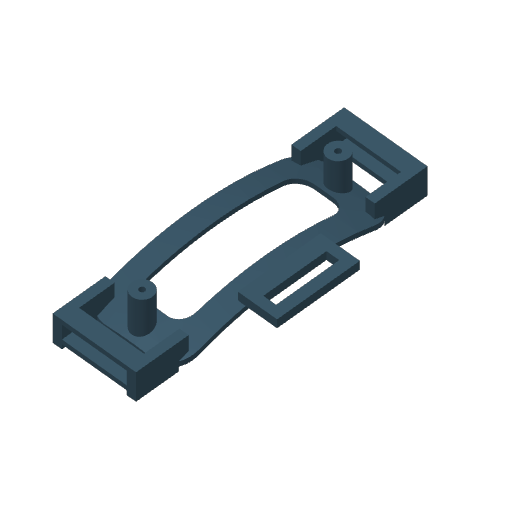
3D打印文件/ArcMask_后枕托穿带修正_20261101/images/plate_1.png
