Morechips/yuntong-smart-glasses/3D打印文件/RDKX5_B3_v0_1_分仓计算盒_20261102/images/04_九件认件.png

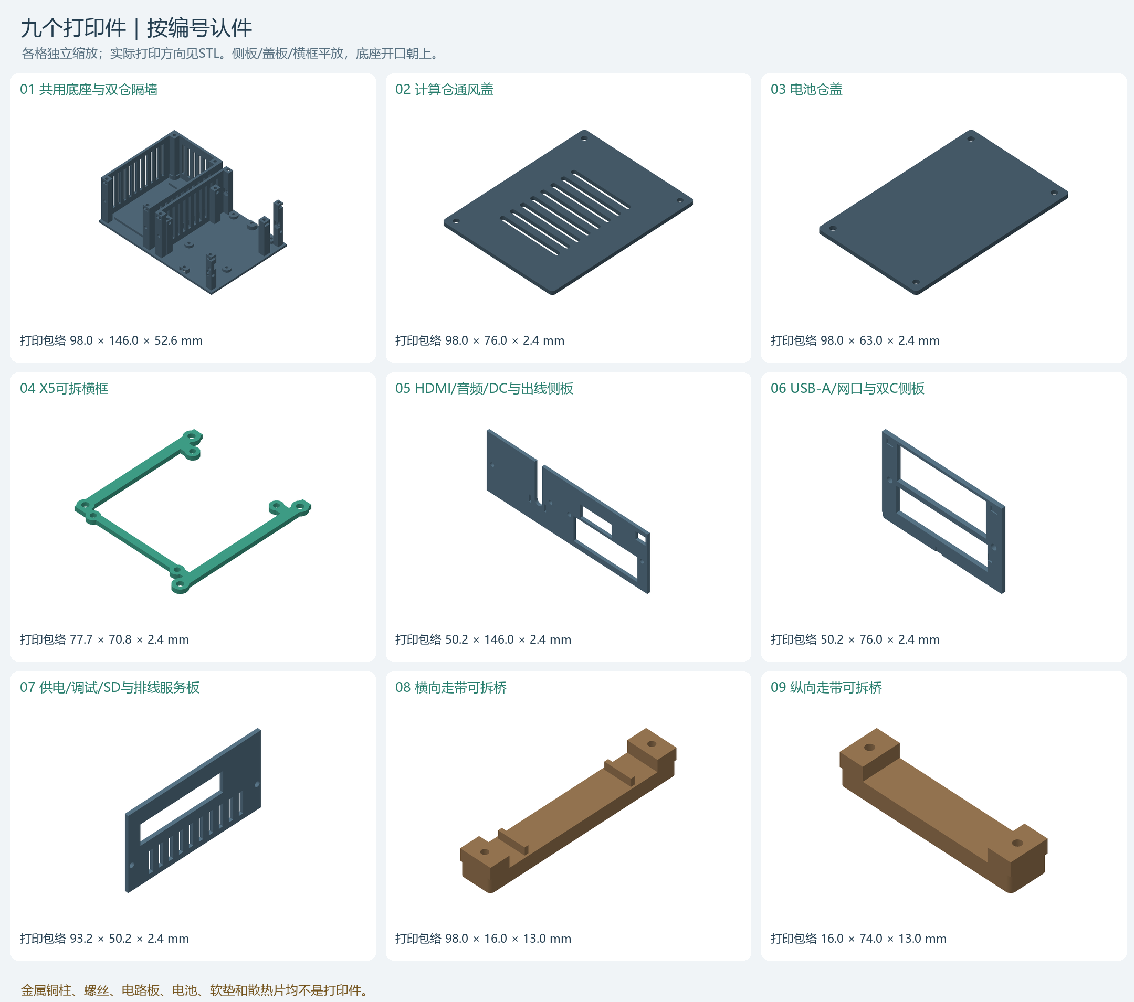
3D打印文件/RDKX5_B3_v0_1_分仓计算盒_20261102/images/04_九件认件.png
