Morechips/yuntong-smart-glasses/3D打印文件/RDKX5_B3_v0_1_分仓计算盒_20261102/images/top_1.png

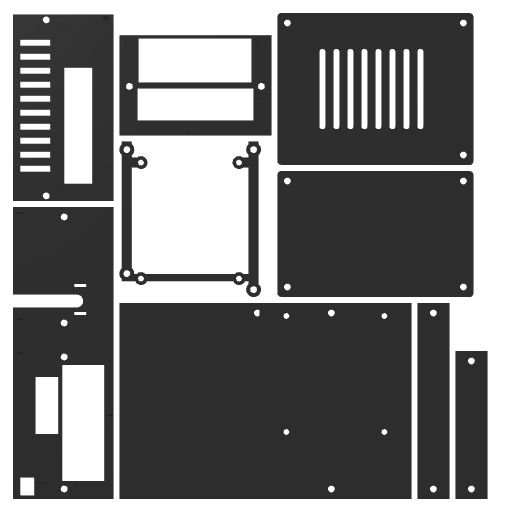
3D打印文件/RDKX5_B3_v0_1_分仓计算盒_20261102/images/top_1.png
