Morechips/yuntong-smart-glasses/3D打印文件/ArcMask_v0_4_B分体内架_20261031/ArcMask_B_v04_assembly_with_refs.step

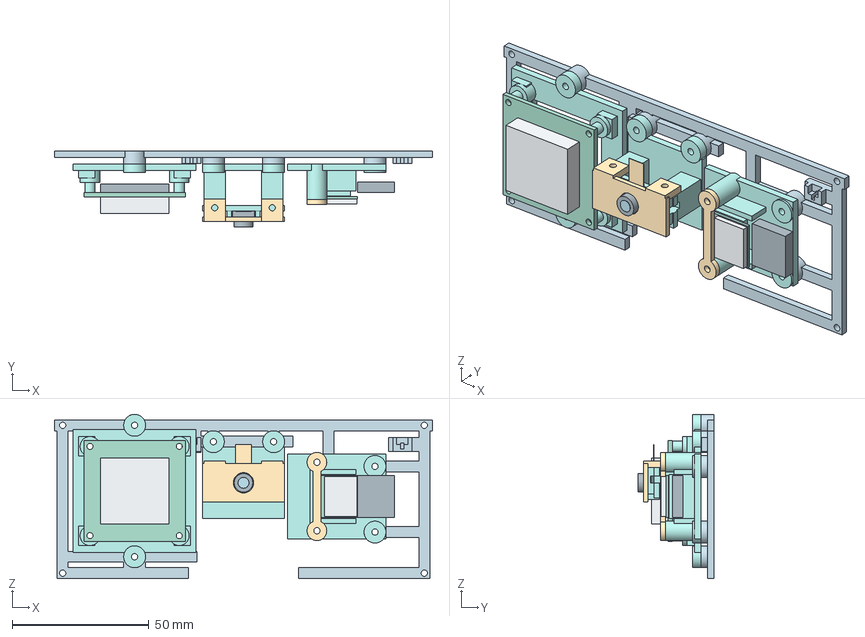
[picture p41: CAD file, 2026-11-03]
3D打印文件/ArcMask_v0_4_B分体内架_20261031/ArcMask_B_v04_assembly_with_refs.step
138.0 x 27.9 x 60.0 mm
B01_common_frame_part
B02_mb_cradle_part
B03_camera_cradle_part
B04_imu_cradle_part
B05_camera_cap_part
B06_imu_keeper_part
ref_MB_PCB_part
ref_MB_front_max_part
ref_MB_back_max_part
ref_camera_base_part
ref_camera_lens_part
ref_glass_part
ref_FPC_exit_only_part
ref_IMU_PCB_part
ref_IMU_shield_envelope_part
ref_IMU_DuPont_envelope_part
