Morechips/yuntong-smart-glasses/3D打印文件/ArcMask_v0_4_B分体内架_20261031/ArcMask_B_v04_printed_assembly.step

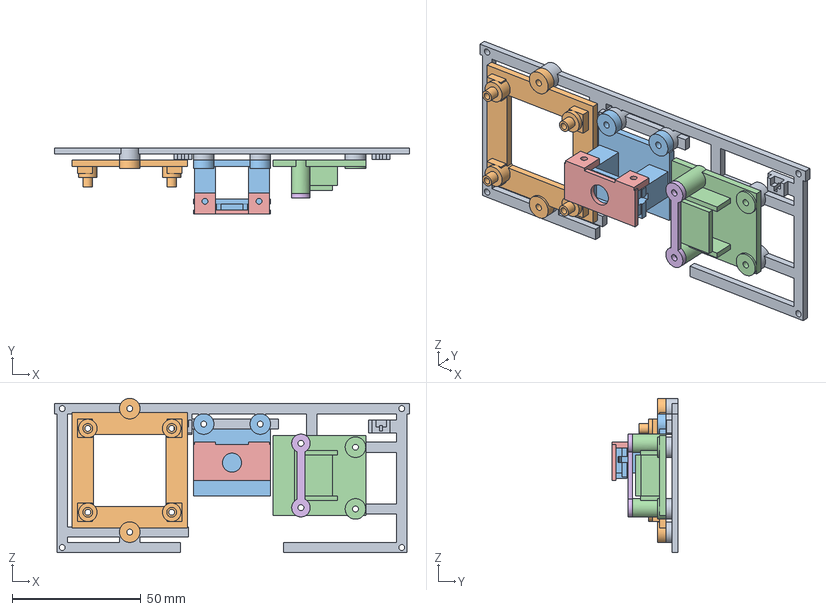
[picture p42: CAD file, 2026-11-03]
3D打印文件/ArcMask_v0_4_B分体内架_20261031/ArcMask_B_v04_printed_assembly.step
138.0 x 25.8 x 60.0 mm
