Morechips/yuntong-smart-glasses/3D打印文件/RDKX5_B3_v0_1_分仓计算盒_20261102/B3_v01_assembly.step

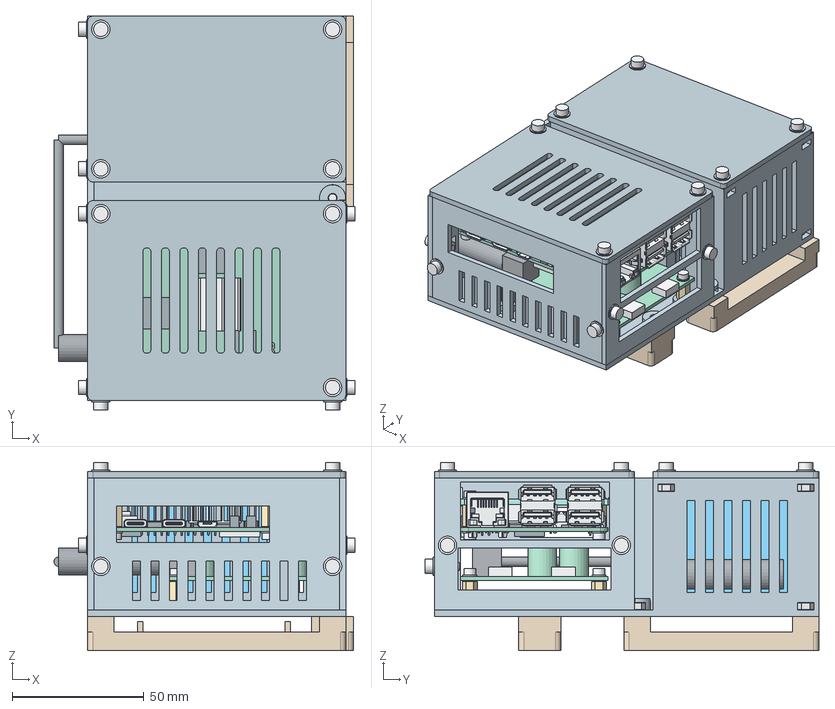
[picture p43: CAD file, 2026-11-03]
3D打印文件/RDKX5_B3_v0_1_分仓计算盒_20261102/B3_v01_assembly.step
114.3 x 149.5 x 71.5 mm
01_common_base_part
02_compute_lid_part
03_battery_lid_part
04_x5_carrier_part
05_left_service_panel_part
06_right_service_panel_part
07_front_service_panel_part
08_waist_bridge_part
09_second_bridge_part
ref_X5_0_part
ref_X5_1_part
ref_X5_2_part
ref_X5_3_part
ref_X5_6_part
ref_X5_63_part
ref_X5_108_part
ref_X5_117_part
ref_X5_132_part
ref_X5_244_part
ref_X5_294_part
ref_X5_694_part
ref_X5_697_part
ref_X5_699_part
ref_X5_700_part
ref_X5_701_part
ref_X5_702_part
ref_X5_703_part
ref_X5_704_part
ref_X5_705_part
ref_P23C_PCB_part
ref_cap_46_part
ref_cap_81_part
ref_DC_jack_part
ref_power_C_25_part
ref_power_C_49_part
ref_battery_part
ref_cell_pad_part
ref_charge_socket_part
ref_TIM_part
ref_heatsink_part
ref_DC_wire_0_part
ref_DC_wire_1_part
ref_DC_wire_2_part
ref_DC_male_part
copper_P_0_part
washer_P_top0_part
washer_P_under0_part
washer_P_base0_part
hw_P_board_0_part
hw_P_base_0_part
copper_P_1_part
washer_P_top1_part
washer_P_under1_part
washer_P_base1_part
hw_P_board_1_part
hw_P_base_1_part
copper_P_2_part
washer_P_top2_part
washer_P_under2_part
washer_P_base2_part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
