Morechips/yuntong-smart-glasses/3D打印文件/ArcMask_v0_3_1_补打加固_20261031/ArcMask_v0_3_1_with_references.step

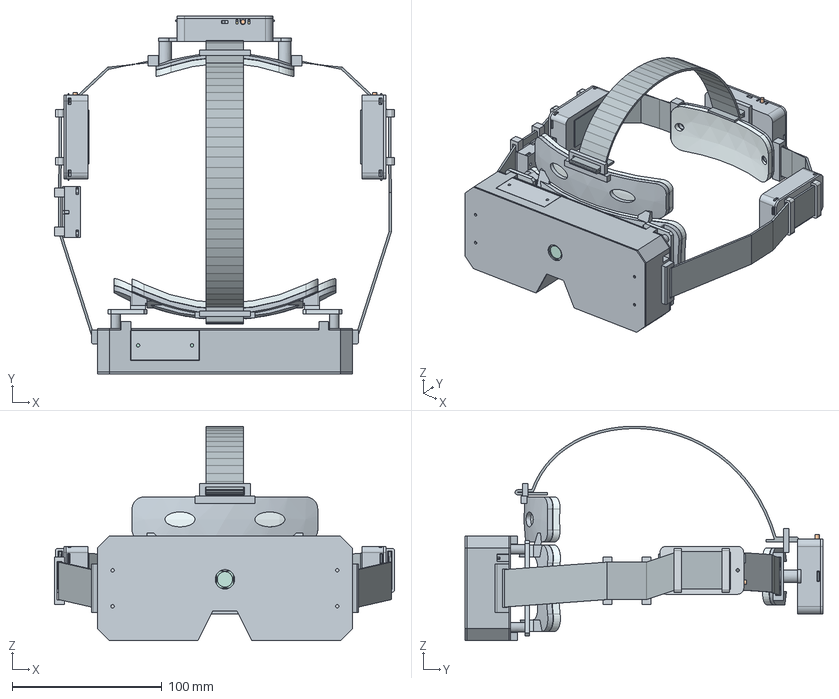
[picture p44: CAD file, 2026-11-03]
3D打印文件/ArcMask_v0_3_1_补打加固_20261031/ArcMask_v0_3_1_with_references.step
227.0 x 238.8 x 143.2 mm
arc_front_flat_lid_part
arc_structural_rim_part
arc_eye_side_barrier_part
arc_top_service_blank_part
arc_rigid_electronics_carrier_part
arc_camera_edge_tray_part
arc_camera_edge_keeper_part
arc_imu_edge_keeper_part
arc_ref_mainboard_plugged_part
arc_ref_camera_raised_part
arc_ref_imu_bent_plugged_part
arc_keepout_fpc_corridor_part
battery_only_tray_part
battery_only_cover_part
battery_measured_reference_part
battery_front_liner_reference_part
battery_retaining_ribbon_reference_part
battery_round_wire_keepout_part
haptic_left_pod_body_part
haptic_left_pod_cover_part
haptic_left_measured_reference_part
haptic_left_trial_inner_pad_part
haptic_left_trial_skin_pad_part
haptic_left_retaining_ribbon_part
haptic_left_round_wire_keepout_part
haptic_right_pod_body_part
haptic_right_pod_cover_part
haptic_right_measured_reference_part
haptic_right_trial_inner_pad_part
haptic_right_trial_skin_pad_part
haptic_right_retaining_ribbon_part
haptic_right_round_wire_keepout_part
wear_removable_forehead_face_frame_part
wear_left_flat_connector_part
wear_right_flat_connector_part
wear_forehead_pad_reference_part
wear_face_pad_reference_part
wear_rear_occipital_cradle_part
wear_rear_pad_reference_part
wear_left_side_band_reference_part
wear_right_side_band_reference_part
wear_top_band_reference_part
speaker_strap_body_part
speaker_strap_cover_part
ref_speaker_2209_part
