Morechips/yuntong-smart-glasses/3D打印文件/ArcMask_v0_3_1_补打加固_20261031/step_parts/wear_left_flat_connector.step

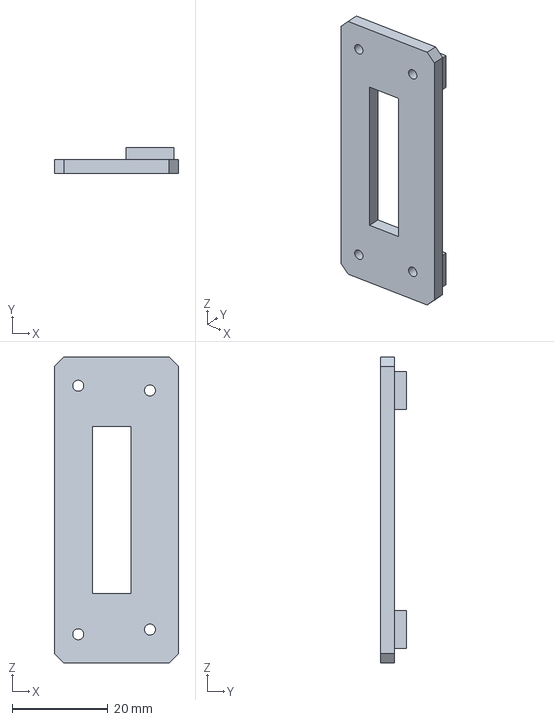
[picture p45: CAD file, 2026-11-03]
3D打印文件/ArcMask_v0_3_1_补打加固_20261031/step_parts/wear_left_flat_connector.step
26.0 x 5.50 x 64.0 mm
