Morechips/yuntong-smart-glasses/3D打印文件/ArcMask_v0_4_B分体内架_20261031/step_parts/B01_common_frame.step

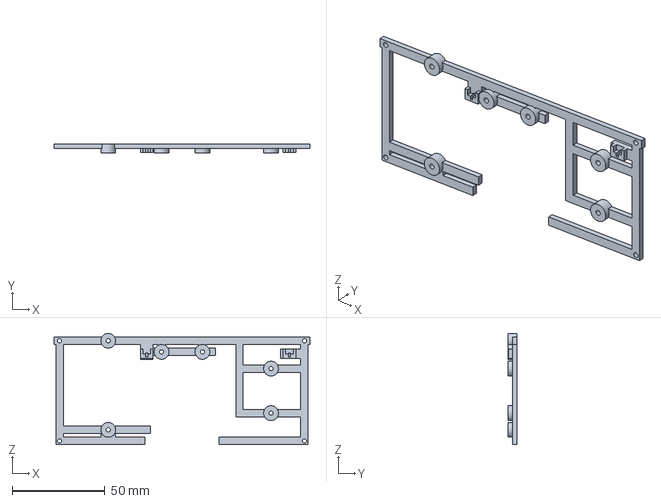
[picture p46: CAD file, 2026-11-03]
3D打印文件/ArcMask_v0_4_B分体内架_20261031/step_parts/B01_common_frame.step
138.0 x 4.80 x 60.0 mm
