Morechips/yuntong-smart-glasses/3D打印文件/ArcMask_v0_5_小振动盒与喇叭修正_20261101/ArcMask_v05_A1_PETG_M2x10_8parts.3mf

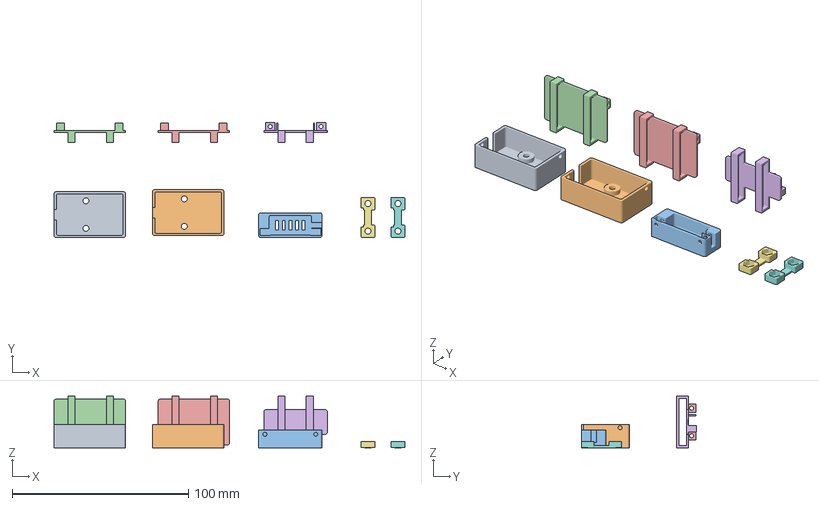
[picture p47: CAD file, 2026-11-03]
3D打印文件/ArcMask_v0_5_小振动盒与喇叭修正_20261101/ArcMask_v05_A1_PETG_M2x10_8parts.3mf
199.0 x 65.2 x 29.3 mm
01_左振动盒体
02_右振动盒体
03_扬声器盒体
04_左振动盖_端向螺丝
05_右振动盖_端向螺丝
06_扬声器盖_侧向螺丝
07_左M3螺母定位条
08_右M3螺母定位条
