Morechips/yuntong-smart-glasses/3D打印文件/ArcMask_v0_5_小振动盒与喇叭修正_20261101/step_parts/H02_cover.step

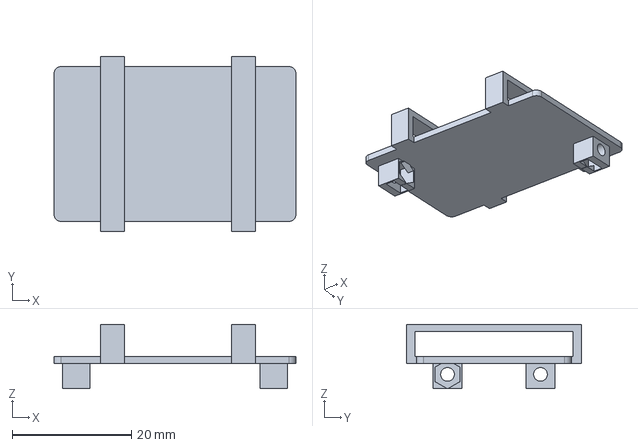
[picture p48: CAD file, 2026-11-03]
3D打印文件/ArcMask_v0_5_小振动盒与喇叭修正_20261101/step_parts/H02_cover.step
40.6 x 29.3 x 10.8 mm
