Morechips/yuntong-smart-glasses/3D打印文件/ArcMask_后枕托穿带修正_20261101/ArcMask_Rear_R01_A1_PETG_1part.3mf

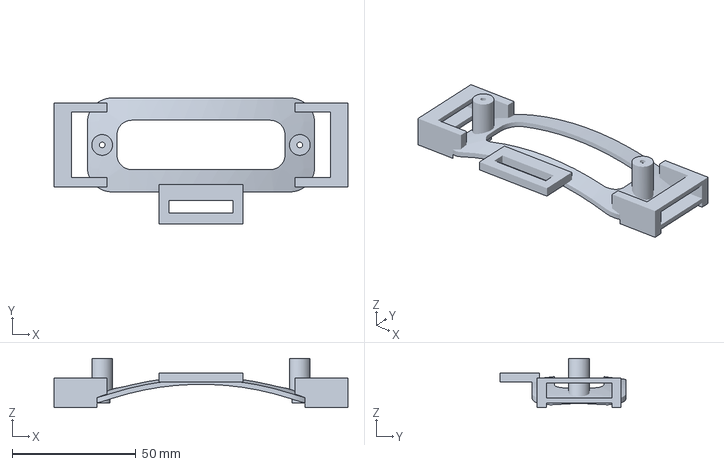
[picture p49: CAD file, 2026-11-03]
3D打印文件/ArcMask_后枕托穿带修正_20261101/ArcMask_Rear_R01_A1_PETG_1part.3mf
119.0 x 51.0 x 20.0 mm
