Morechips/yuntong-smart-glasses/3D打印文件/RDKX5_B3_v0_1_分仓计算盒_20261102/B3_v01_A1_PETG_9件.3mf

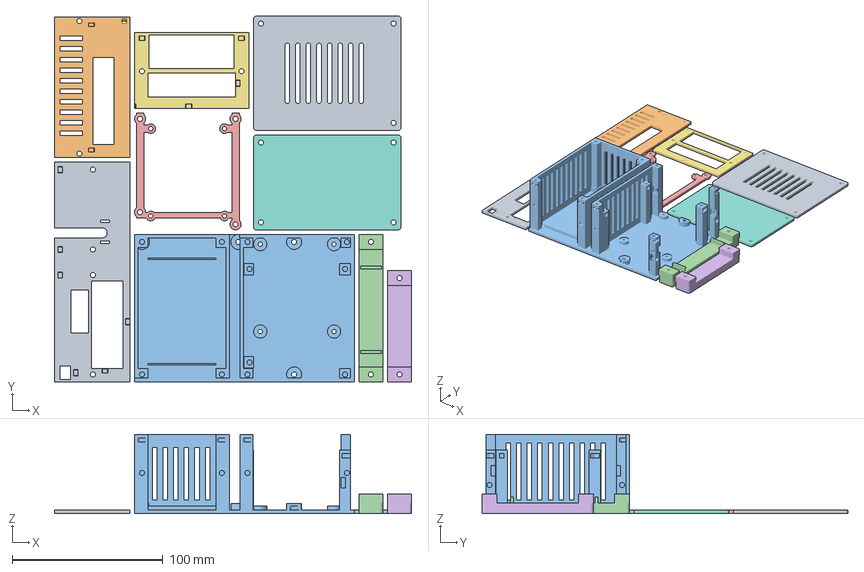
[picture p50: CAD file, 2026-11-03]
3D打印文件/RDKX5_B3_v0_1_分仓计算盒_20261102/B3_v01_A1_PETG_9件.3mf
237.2 x 243.0 x 52.6 mm
05_left_service_panel
07_front_service_panel
01_common_base
08_waist_bridge
04_x5_carrier
09_second_bridge
06_right_service_panel
03_battery_lid
02_compute_lid
