Morechips/yuntong-smart-glasses/3D打印文件/RDKX5_B3_v0_1_分仓计算盒_20261102/step/02_compute_lid.step

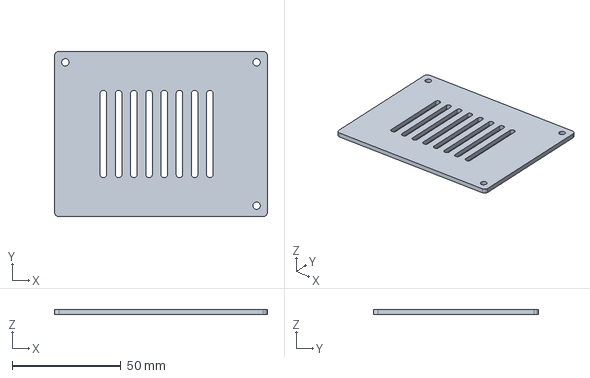
[picture p51: CAD file, 2026-11-03]
3D打印文件/RDKX5_B3_v0_1_分仓计算盒_20261102/step/02_compute_lid.step
98.0 x 76.0 x 2.40 mm
