Morechips/yuntong-smart-glasses/3D打印文件/ArcMask_v0_3_1_补打加固_20261031/ArcMask_v031_A1_PETG_仅补打5件_两盘.3mf

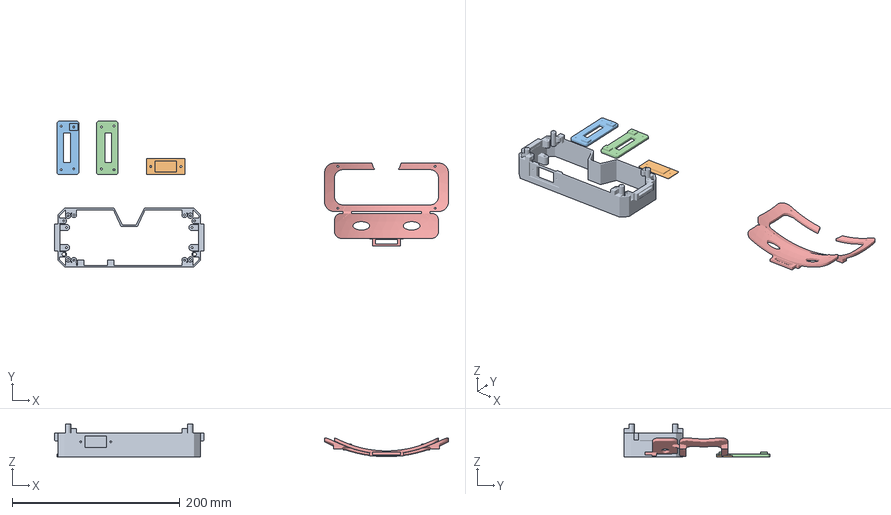
[picture p52: CAD file, 2026-11-03]
3D打印文件/ArcMask_v0_3_1_补打加固_20261031/ArcMask_v031_A1_PETG_仅补打5件_两盘.3mf
470.2 x 174.0 x 38.8 mm
01_加固结构外圈
02_加宽检修盖_孔距36
03_左连接片_平面贴床
04_右连接片_平面贴床
05_加强额托脸垫架
