Morechips/yuntong-smart-glasses/3D打印文件/ArcMask_v0_3_1_补打加固_20261031/step_parts/arc_camera_edge_tray.step

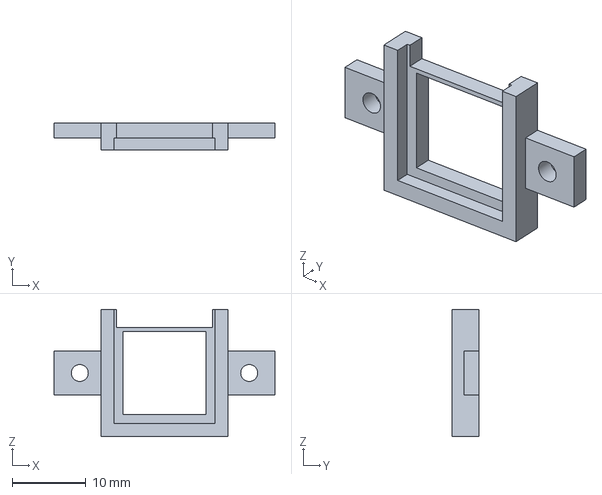
[picture p53: CAD file, 2026-11-03]
3D打印文件/ArcMask_v0_3_1_补打加固_20261031/step_parts/arc_camera_edge_tray.step
30.0 x 3.60 x 17.3 mm
