Morechips/yuntong-smart-glasses/3D打印文件/ArcMask_v0_3_1_补打加固_20261031/stl_fit_parts/haptic_left_pod_body.stl

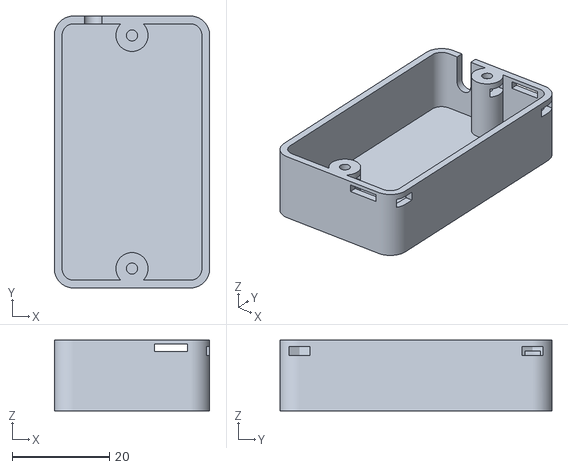
[picture p54: CAD file, 2026-11-03]
3D打印文件/ArcMask_v0_3_1_补打加固_20261031/stl_fit_parts/haptic_left_pod_body.stl
32.0 x 56.0 x 14.6
