Morechips/yuntong-smart-glasses/3D打印文件/ArcMask_v0_4_B分体内架_20261031/step_parts/B05_camera_cap.step

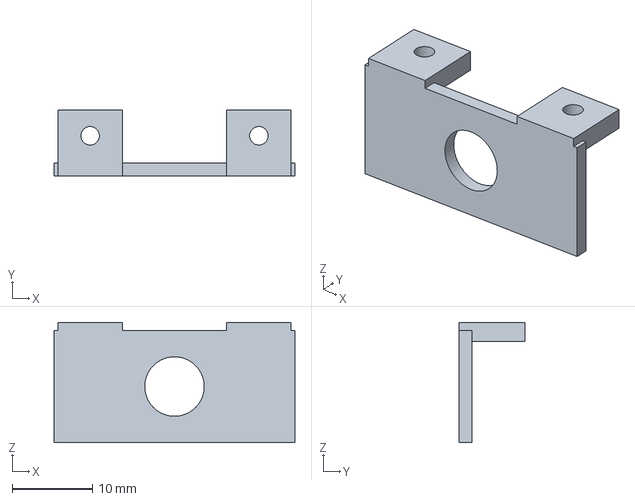
[picture p55: CAD file, 2026-11-03]
3D打印文件/ArcMask_v0_4_B分体内架_20261031/step_parts/B05_camera_cap.step
30.0 x 8.20 x 15.0 mm
