Morechips/yuntong-smart-glasses/3D打印文件/ArcMask_v0_5_小振动盒与喇叭修正_20261101/OPTIONAL_Backplate_A1_PETG_1part.3mf

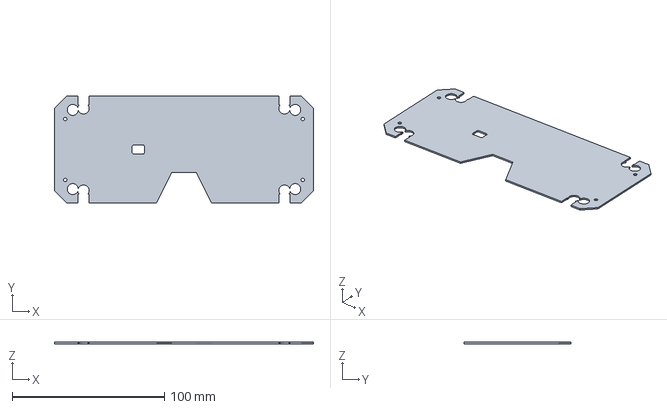
[picture p56: CAD file, 2026-11-03]
3D打印文件/ArcMask_v0_5_小振动盒与喇叭修正_20261101/OPTIONAL_Backplate_A1_PETG_1part.3mf
170.0 x 70.0 x 1.00 mm
