Morechips/yuntong-smart-glasses/3D打印文件/ArcMask_v0_5_小振动盒与喇叭修正_20261101/step_parts/H01_body.step

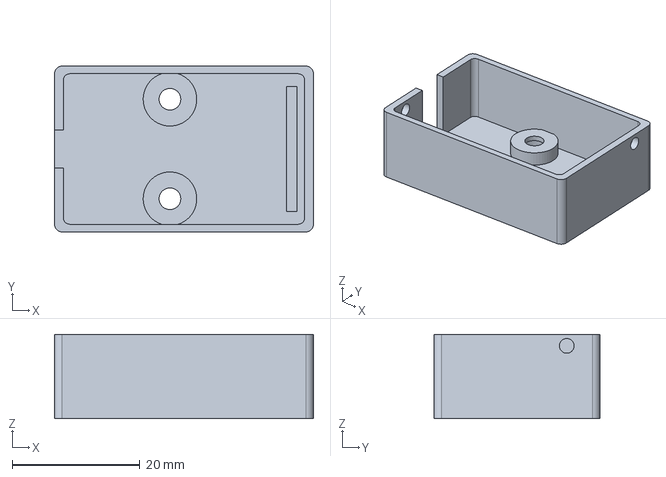
[picture p57: CAD file, 2026-11-03]
3D打印文件/ArcMask_v0_5_小振动盒与喇叭修正_20261101/step_parts/H01_body.step
40.6 x 26.0 x 13.2 mm
