Morechips/yuntong-smart-glasses/3D打印文件/RDKX5_B3_v0_1_分仓计算盒_20261102/B3_v01_临时M3套筒五金参考.step

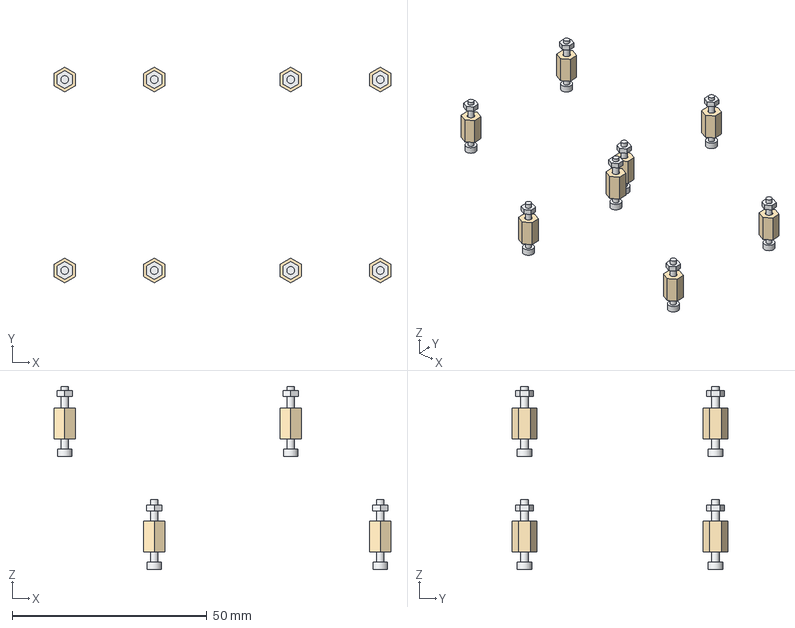
[picture p58: CAD file, 2026-11-03]
3D打印文件/RDKX5_B3_v0_1_分仓计算盒_20261102/B3_v01_临时M3套筒五金参考.step
86.5 x 55.4 x 47.0 mm
tmp_spacer_power0_part
tmp_bolt_power0_part
tmp_nut_power0_part
tmp_spacer_power1_part
tmp_bolt_power1_part
tmp_nut_power1_part
tmp_spacer_power2_part
tmp_bolt_power2_part
tmp_nut_power2_part
tmp_spacer_power3_part
tmp_bolt_power3_part
tmp_nut_power3_part
tmp_spacer_x50_part
tmp_bolt_x50_part
tmp_nut_x50_part
tmp_spacer_x51_part
tmp_bolt_x51_part
tmp_nut_x51_part
tmp_spacer_x52_part
tmp_bolt_x52_part
tmp_nut_x52_part
tmp_spacer_x53_part
tmp_bolt_x53_part
tmp_nut_x53_part
