Morechips/yuntong-smart-glasses/3D打印文件/RDKX5_B3_v0_1_分仓计算盒_20261102/step/09_second_bridge.step

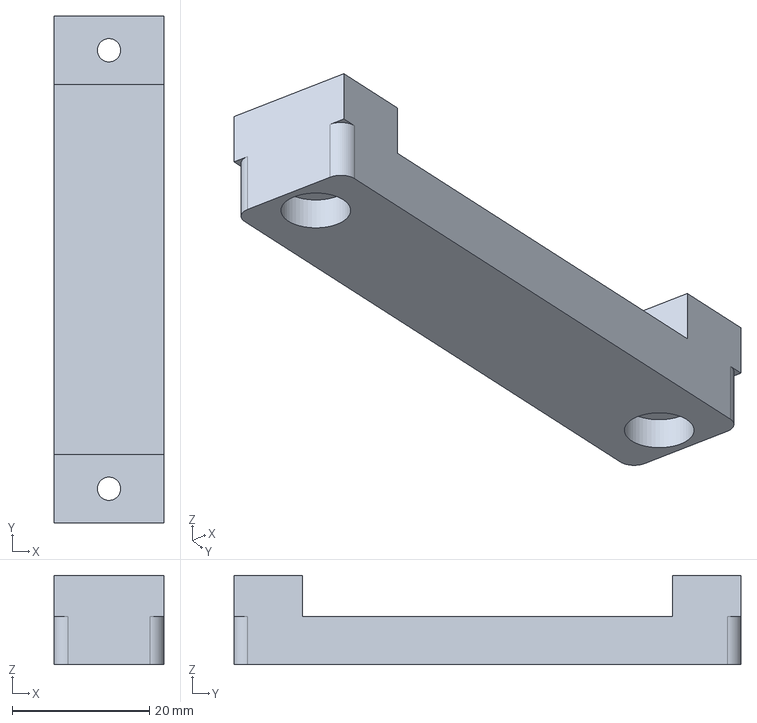
[picture p59: CAD file, 2026-11-03]
3D打印文件/RDKX5_B3_v0_1_分仓计算盒_20261102/step/09_second_bridge.step
16.0 x 74.0 x 13.0 mm
