Morechips/yuntong-smart-glasses/3D打印文件/ArcMask_v0_3_1_补打加固_20261031/ArcMask_v0_3_1_printed.step

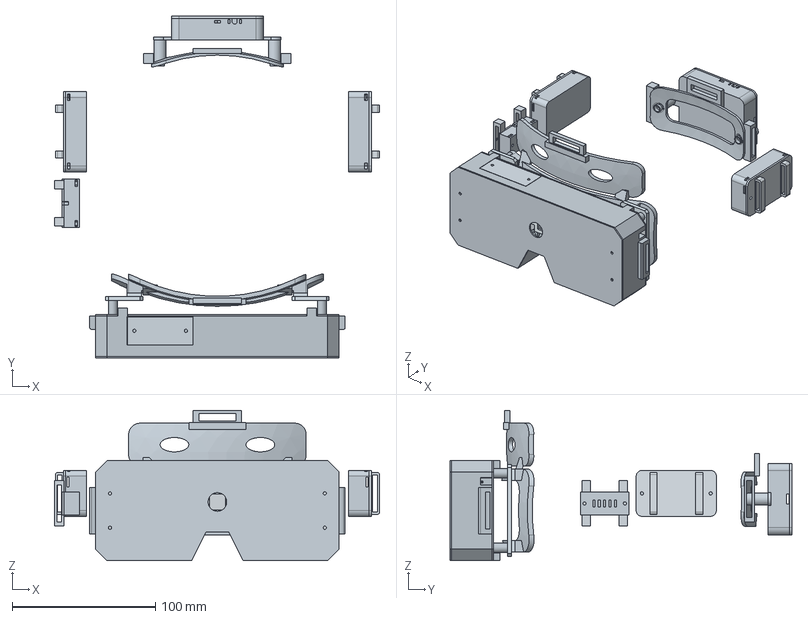
[picture p60: CAD file, 2026-11-03]
3D打印文件/ArcMask_v0_3_1_补打加固_20261031/ArcMask_v0_3_1_printed.step
227.0 x 238.8 x 105.0 mm
arc_front_flat_lid_part
arc_structural_rim_part
arc_eye_side_barrier_part
arc_top_service_blank_part
arc_rigid_electronics_carrier_part
arc_camera_edge_tray_part
arc_camera_edge_keeper_part
arc_imu_edge_keeper_part
battery_only_tray_part
battery_only_cover_part
haptic_left_pod_body_part
haptic_left_pod_cover_part
haptic_right_pod_body_part
haptic_right_pod_cover_part
wear_removable_forehead_face_frame_part
wear_left_flat_connector_part
wear_right_flat_connector_part
wear_rear_occipital_cradle_part
speaker_strap_body_part
speaker_strap_cover_part
