Morechips/yuntong-smart-glasses/3D打印文件/ArcMask_v0_3_1_补打加固_20261031/step_parts/arc_front_flat_lid.step

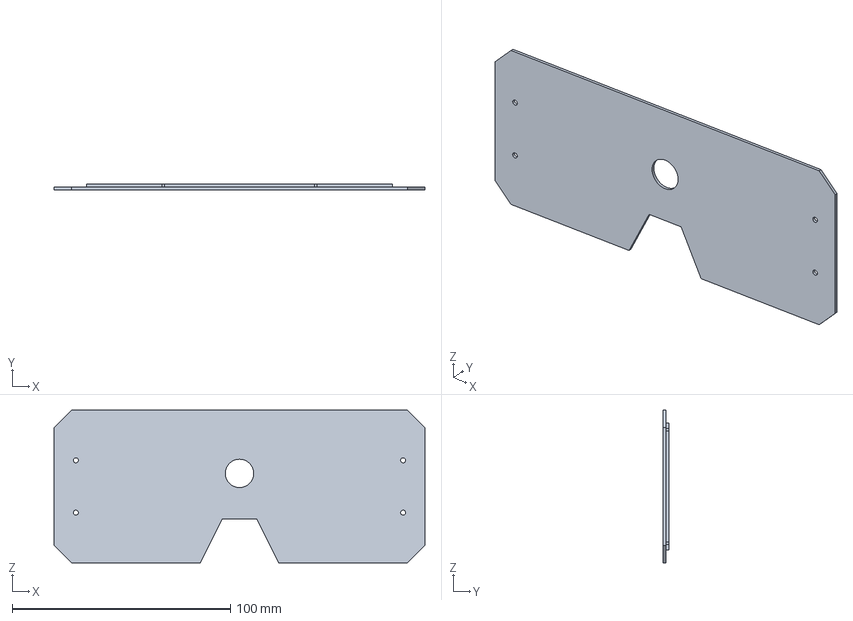
[picture p61: CAD file, 2026-11-03]
3D打印文件/ArcMask_v0_3_1_补打加固_20261031/step_parts/arc_front_flat_lid.step
170.0 x 2.60 x 70.0 mm
