Morechips/yuntong-smart-glasses/3D打印文件/ArcMask_v0_3_1_补打加固_20261031/stl_fit_parts/battery_only_tray.stl

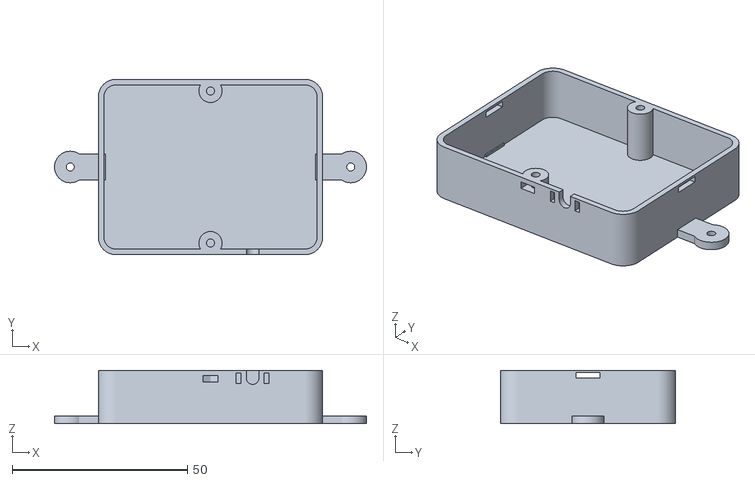
[picture p62: CAD file, 2026-11-03]
3D打印文件/ArcMask_v0_3_1_补打加固_20261031/stl_fit_parts/battery_only_tray.stl
89.0 x 50.0 x 15.2
