Morechips/yuntong-smart-glasses/3D打印文件/ArcMask_v0_4_B分体内架_20261031/ArcMask_B_v04_A1_PETG_6parts.3mf

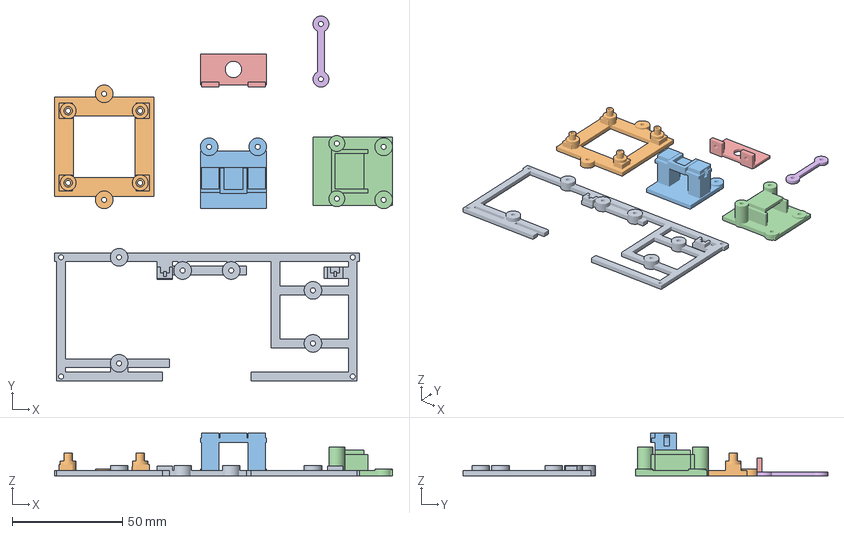
[picture p63: CAD file, 2026-11-03]
3D打印文件/ArcMask_v0_4_B分体内架_20261031/ArcMask_B_v04_A1_PETG_6parts.3mf
153.0 x 165.2 x 19.4 mm
01_共同骨架_背面贴床
02_主板托架_柱朝上
03_相机托座_局部支撑
04_IMU托座_局部支撑
05_相机上锁压盖
06_IMU限位条
