Morechips/yuntong-smart-glasses/3D打印文件/ArcMask_v0_4_B分体内架_20261031/step_parts/B04_imu_cradle.step

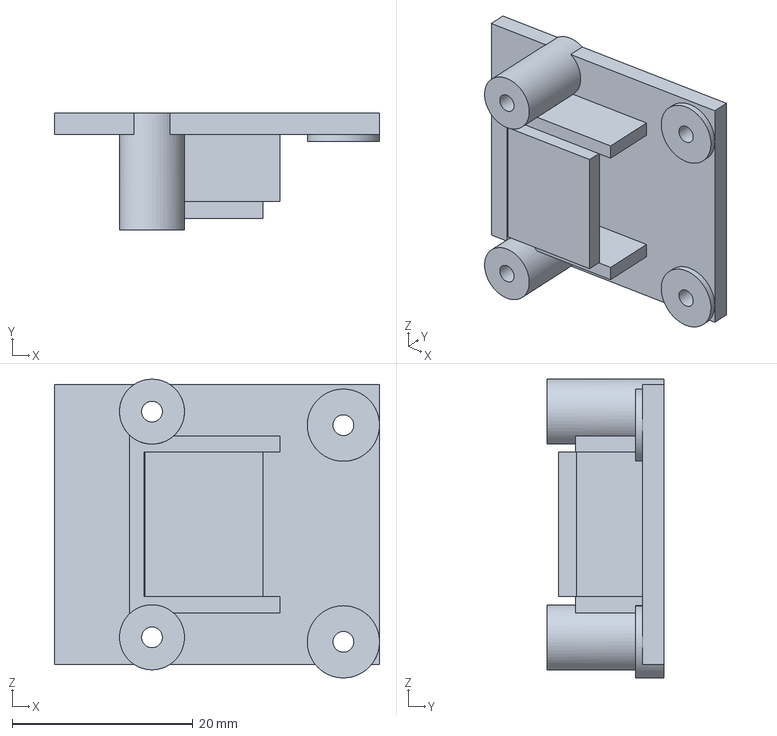
[picture p64: CAD file, 2026-11-03]
3D打印文件/ArcMask_v0_4_B分体内架_20261031/step_parts/B04_imu_cradle.step
36.0 x 13.0 x 33.1 mm
