Morechips/yuntong-smart-glasses/3D打印文件/ArcMask_v0_5_小振动盒与喇叭修正_20261101/step_parts/S02_cover.step

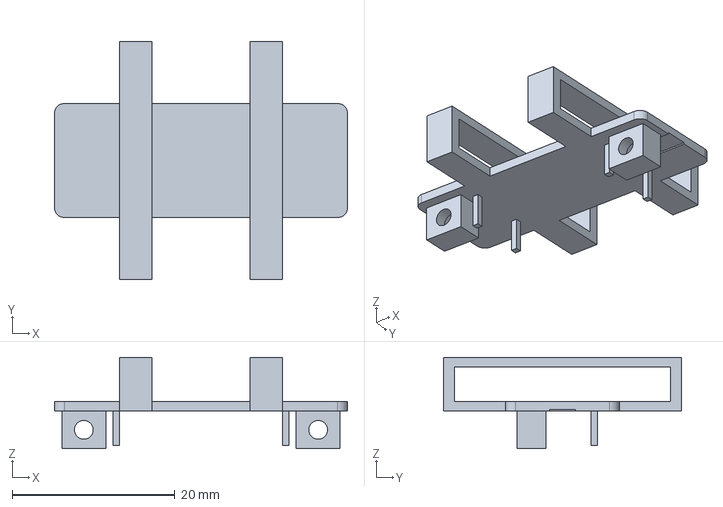
[picture p65: CAD file, 2026-11-03]
3D打印文件/ArcMask_v0_5_小振动盒与喇叭修正_20261101/step_parts/S02_cover.step
36.0 x 29.3 x 11.2 mm
