Morechips/yuntong-smart-glasses/3D打印文件/RDKX5_B3_v0_1_分仓计算盒_20261102/step/05_left_service_panel.step

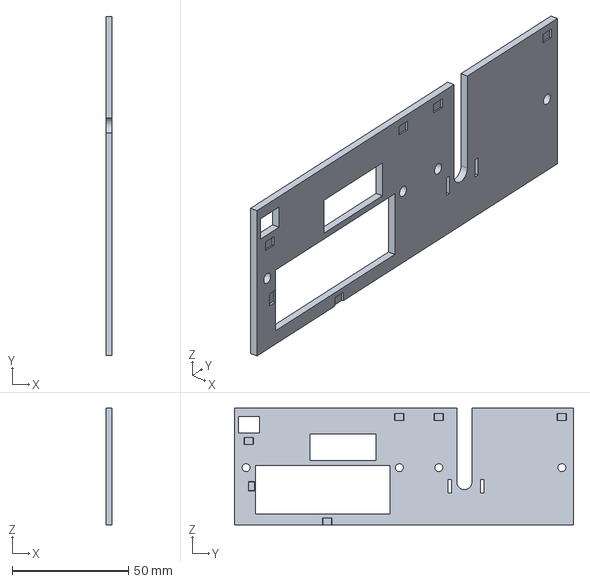
[picture p66: CAD file, 2026-11-03]
3D打印文件/RDKX5_B3_v0_1_分仓计算盒_20261102/step/05_left_service_panel.step
2.40 x 146.0 x 50.2 mm
