Morechips/yuntong-smart-glasses/3D打印文件/ArcMask_v0_4_B分体内架_20261031/step_parts/B06_imu_keeper.step

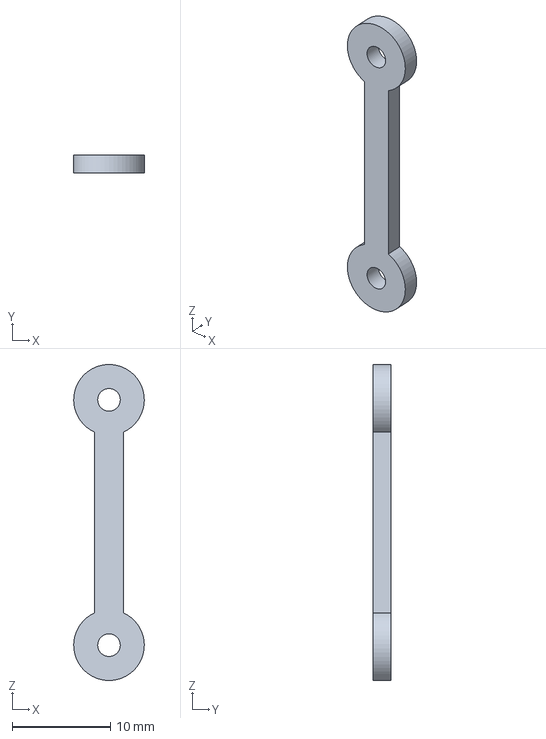
[picture p67: CAD file, 2026-11-03]
3D打印文件/ArcMask_v0_4_B分体内架_20261031/step_parts/B06_imu_keeper.step
7.20 x 1.80 x 32.2 mm
