Morechips/yuntong-smart-glasses/3D打印文件/ArcMask_v0_5_小振动盒与喇叭修正_20261101/step_parts/S01_body.step

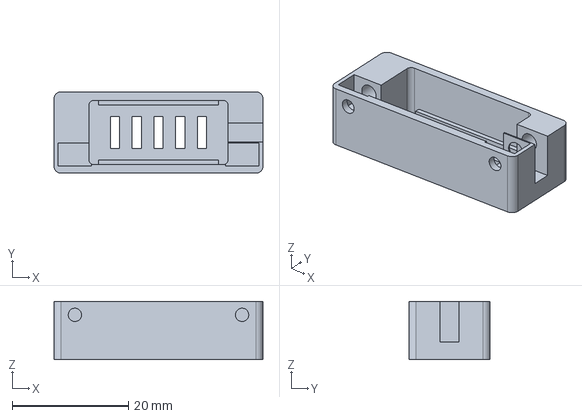
[picture p68: CAD file, 2026-11-03]
3D打印文件/ArcMask_v0_5_小振动盒与喇叭修正_20261101/step_parts/S01_body.step
36.0 x 14.0 x 10.0 mm
