Morechips/yuntong-smart-glasses/3D打印文件/ArcMask_v0_3_1_补打加固_20261031/step_parts/m2_fit_coupon.step

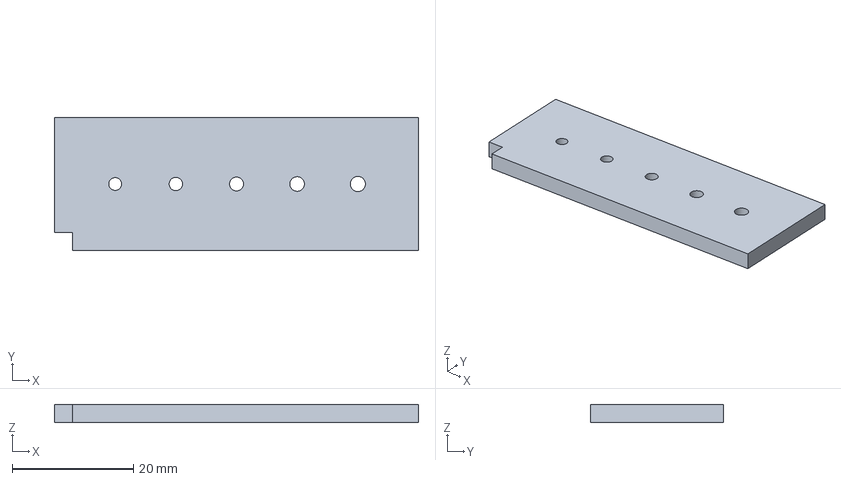
[picture p70: CAD file, 2026-11-03]
3D打印文件/ArcMask_v0_3_1_补打加固_20261031/step_parts/m2_fit_coupon.step
60.0 x 22.0 x 3.00 mm
