Morechips/yuntong-smart-glasses/3D打印文件/ArcMask_v0_4_B分体内架_20261031/step_parts/B03_camera_cradle.step

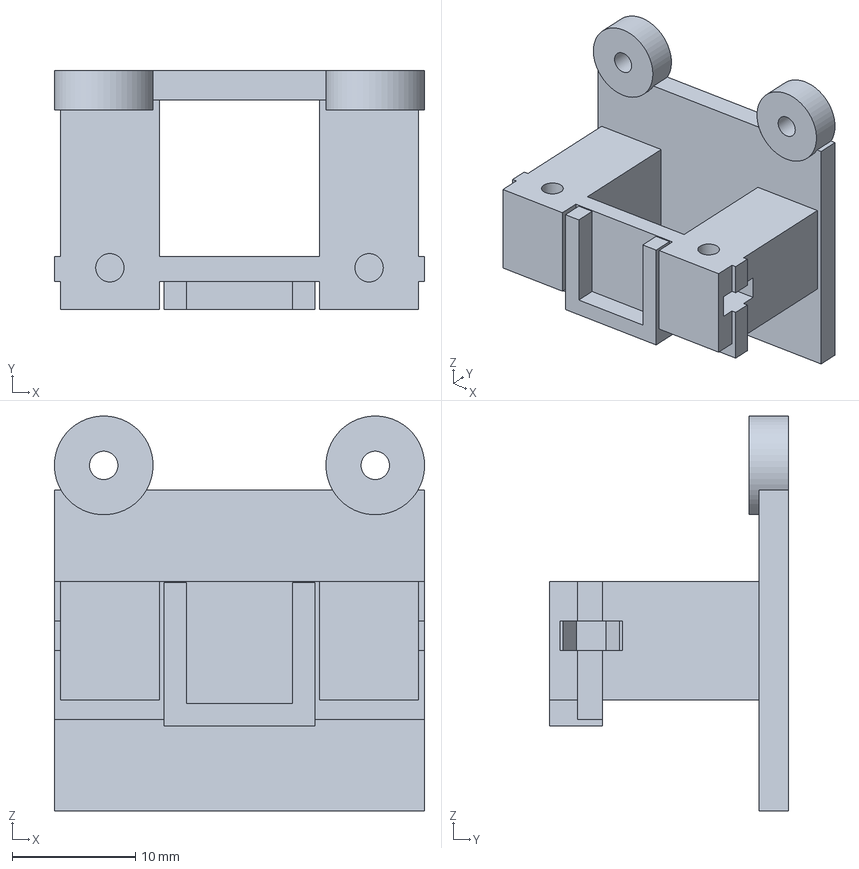
[picture p71: CAD file, 2026-11-03]
3D打印文件/ArcMask_v0_4_B分体内架_20261031/step_parts/B03_camera_cradle.step
30.0 x 19.4 x 32.0 mm
