Morechips/yuntong-smart-glasses/3D打印文件/RDKX5_B3_v0_1_分仓计算盒_20261102/step/07_front_service_panel.step

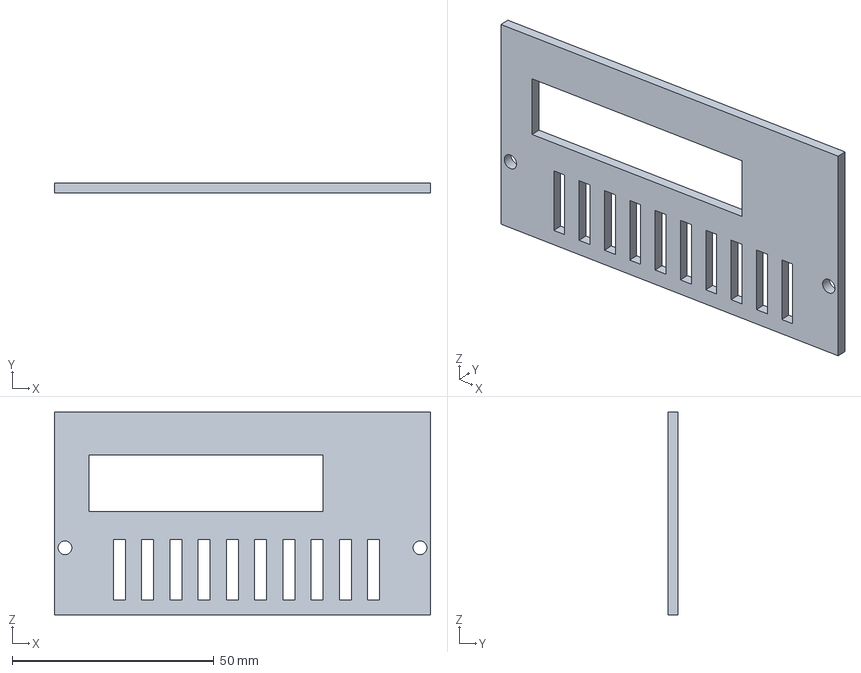
[picture p72: CAD file, 2026-11-03]
3D打印文件/RDKX5_B3_v0_1_分仓计算盒_20261102/step/07_front_service_panel.step
93.2 x 2.40 x 50.2 mm
