Morechips/yuntong-smart-glasses/3D打印文件/ArcMask_v0_3_1_补打加固_20261031/step_parts/battery_only_cover.step

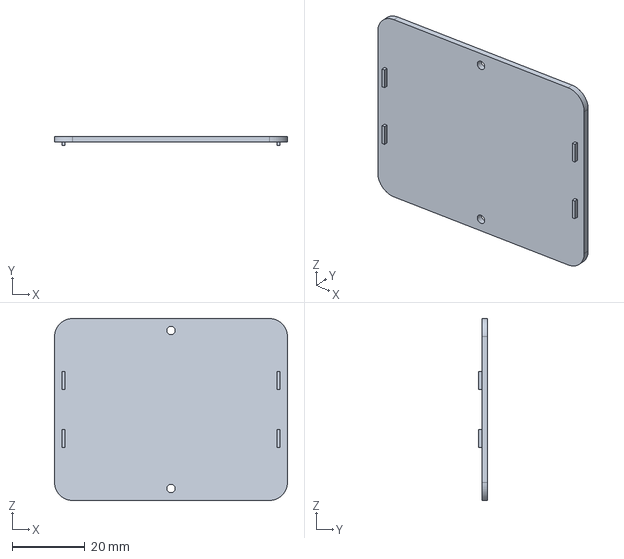
[picture p73: CAD file, 2026-11-03]
3D打印文件/ArcMask_v0_3_1_补打加固_20261031/step_parts/battery_only_cover.step
64.0 x 2.60 x 50.0 mm
