Morechips/yuntong-smart-glasses/3D打印文件/ArcMask_v0_4_B分体内架_20261031/step_parts/B02_mb_cradle.step

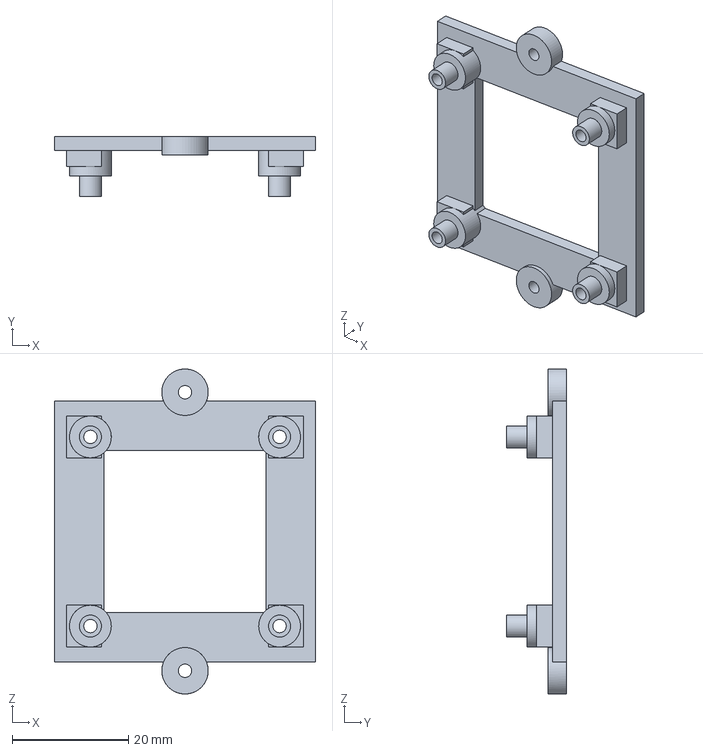
[picture p74: CAD file, 2026-11-03]
3D打印文件/ArcMask_v0_4_B分体内架_20261031/step_parts/B02_mb_cradle.step
45.0 x 10.4 x 56.0 mm
