Morechips/yuntong-smart-glasses/3D打印文件/RDKX5_B3_v0_1_分仓计算盒_20261102/step/04_x5_carrier.step

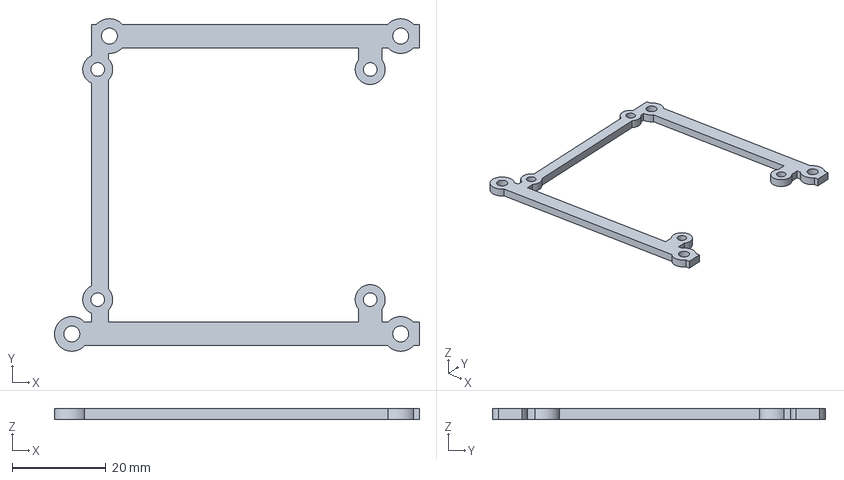
[picture p75: CAD file, 2026-11-03]
3D打印文件/RDKX5_B3_v0_1_分仓计算盒_20261102/step/04_x5_carrier.step
77.7 x 70.8 x 2.40 mm
