Morechips/yuntong-smart-glasses/3D打印文件/ArcMask_v0_3_1_补打加固_20261031/step_parts/arc_imu_edge_keeper.step

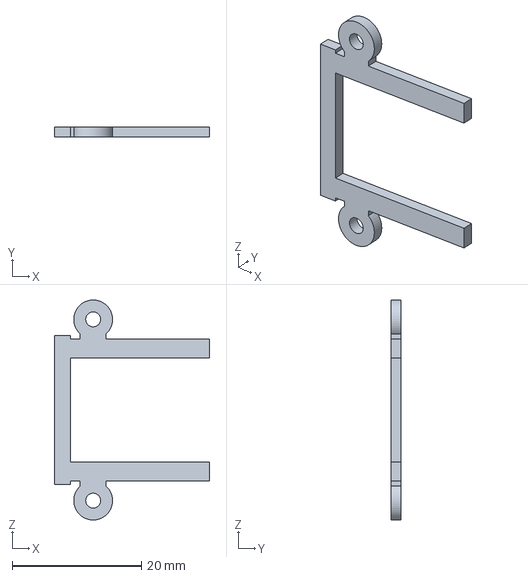
[picture p76: CAD file, 2026-11-03]
3D打印文件/ArcMask_v0_3_1_补打加固_20261031/step_parts/arc_imu_edge_keeper.step
24.0 x 1.60 x 34.0 mm
