Morechips/yuntong-smart-glasses/3D打印文件/ArcMask_v0_3_1_补打加固_20261031/step_parts/wear_rear_occipital_cradle.step

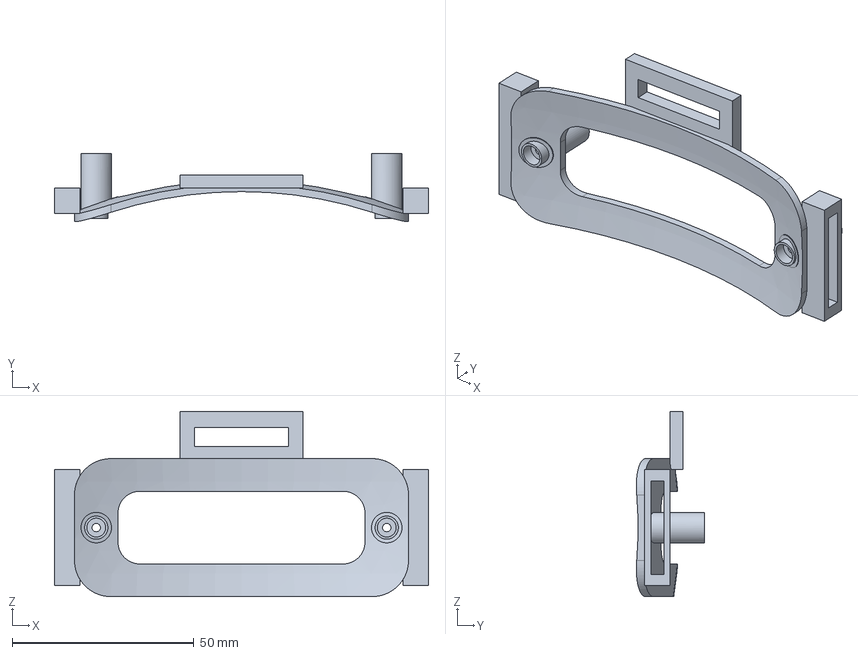
[picture p78: CAD file, 2026-11-03]
3D打印文件/ArcMask_v0_3_1_补打加固_20261031/step_parts/wear_rear_occipital_cradle.step
103.0 x 18.8 x 51.0 mm
