Morechips/yuntong-smart-glasses/3D打印文件/ArcMask_v0_3_1_补打加固_20261031/step_parts/haptic_right_pod_cover.step

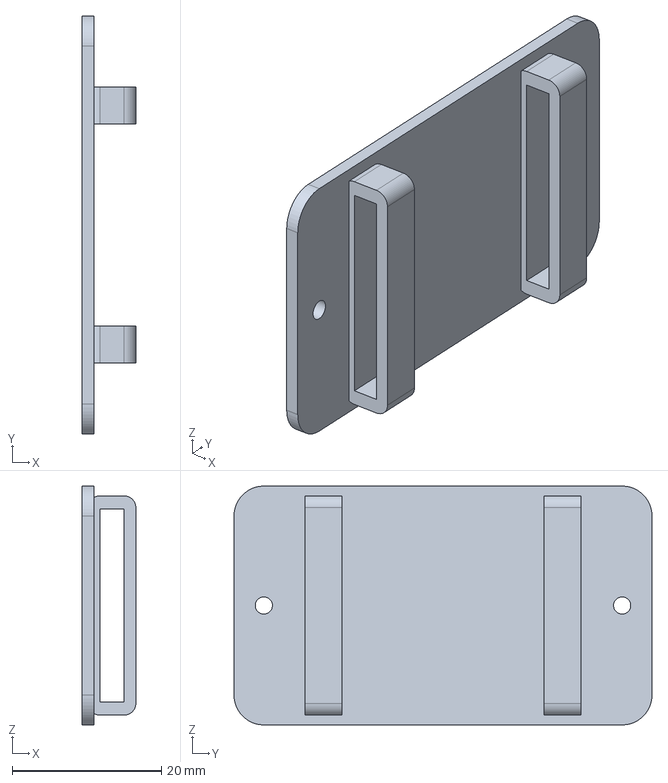
[picture p80: CAD file, 2026-11-03]
3D打印文件/ArcMask_v0_3_1_补打加固_20261031/step_parts/haptic_right_pod_cover.step
7.20 x 56.0 x 32.0 mm
