Morechips/yuntong-smart-glasses/3D打印文件/ArcMask_v0_3_1_补打加固_20261031/stl_fit_parts/arc_camera_edge_keeper.stl

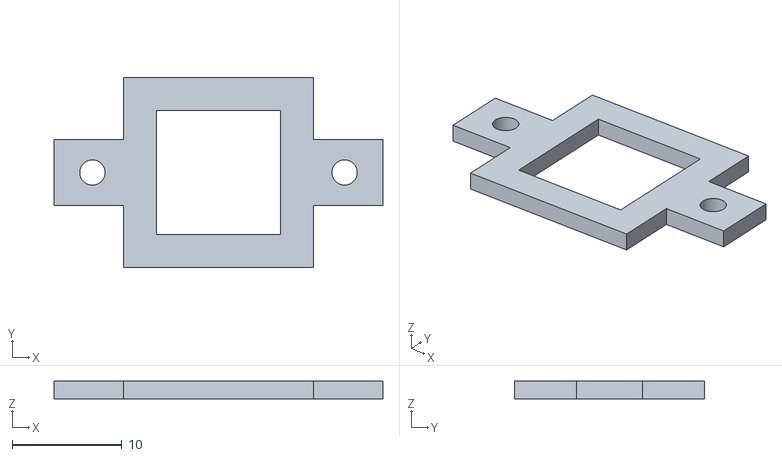
[picture p82: CAD file, 2026-11-03]
3D打印文件/ArcMask_v0_3_1_补打加固_20261031/stl_fit_parts/arc_camera_edge_keeper.stl
30.0 x 17.3 x 1.60
