Morechips/yuntong-smart-glasses/3D打印文件/ArcMask_v0_3_1_补打加固_20261031/step_parts/speaker_strap_cover.step

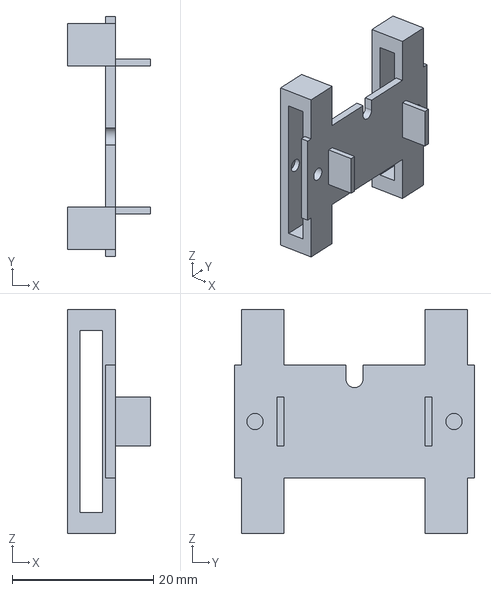
[picture p83: CAD file, 2026-11-03]
3D打印文件/ArcMask_v0_3_1_补打加固_20261031/step_parts/speaker_strap_cover.step
11.8 x 34.0 x 31.8 mm
