Morechips/yuntong-smart-glasses/3D打印文件/ArcMask_v0_3_1_补打加固_20261031/stl_fit_parts/arc_structural_rim.stl

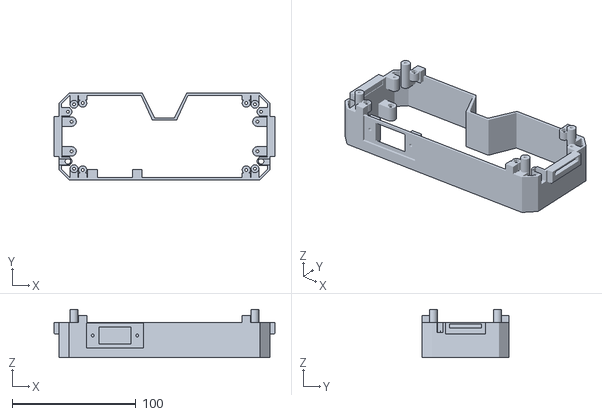
[picture p84: CAD file, 2026-11-03]
3D打印文件/ArcMask_v0_3_1_补打加固_20261031/stl_fit_parts/arc_structural_rim.stl
178.4 x 70.0 x 38.8
