Morechips/yuntong-smart-glasses/3D打印文件/ArcMask_v0_3_1_补打加固_20261031/stl_fit_parts/arc_rigid_electronics_carrier.stl

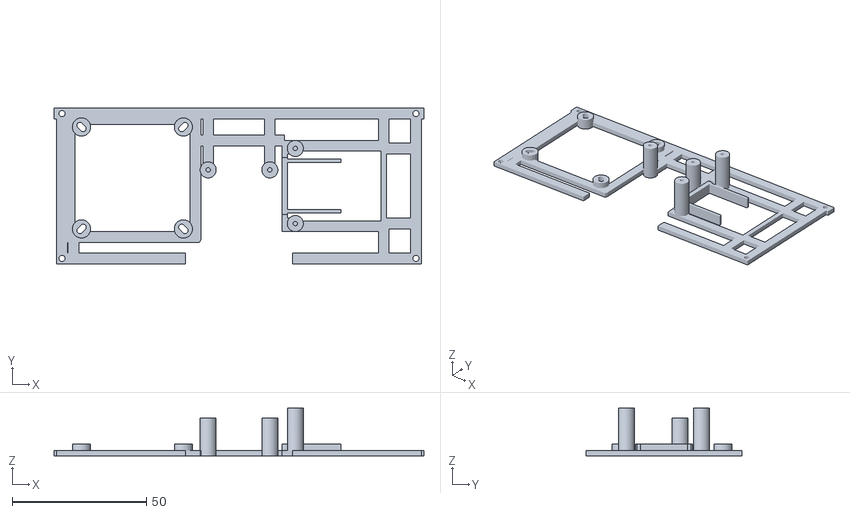
[picture p85: CAD file, 2026-11-03]
3D打印文件/ArcMask_v0_3_1_补打加固_20261031/stl_fit_parts/arc_rigid_electronics_carrier.stl
138.0 x 58.0 x 17.8
