Morechips/yuntong-smart-glasses/3D打印文件/ArcMask_v0_3_1_补打加固_20261031/stl_fit_parts/arc_top_service_blank.stl

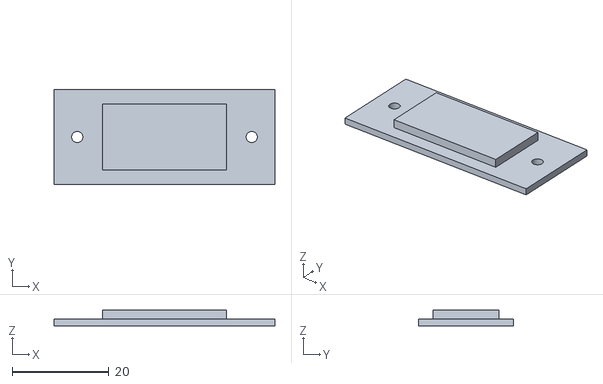
[picture p86: CAD file, 2026-11-03]
3D打印文件/ArcMask_v0_3_1_补打加固_20261031/stl_fit_parts/arc_top_service_blank.stl
45.6 x 19.6 x 3.20
