Morechips/yuntong-smart-glasses/3D打印文件/ArcMask_v0_3_1_补打加固_20261031/stl_fit_parts/wear_removable_forehead_face_frame.stl

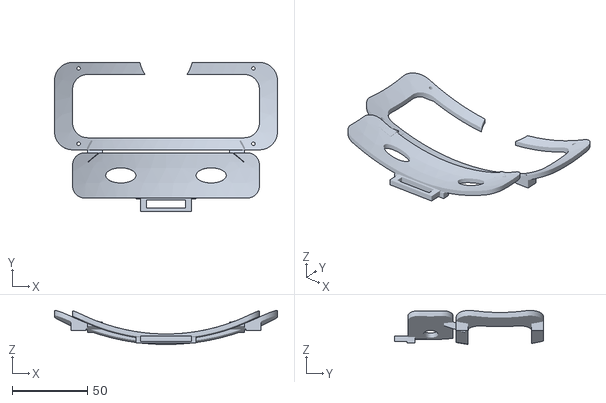
[picture p88: CAD file, 2026-11-03]
3D打印文件/ArcMask_v0_3_1_补打加固_20261031/stl_fit_parts/wear_removable_forehead_face_frame.stl
148.0 x 99.0 x 22.6
