Morechips/yuntong-smart-glasses/(list of files, cad)

Other CAD files:
3D打印文件/ArcMask_v0_3_1_补打加固_20261031/stl_fit_parts/wear_left_flat_connector.stl
3D打印文件/ArcMask_后枕托穿带修正_20261101/step_parts/R01_rear_cradle_clear_strap.step
3D打印文件/ArcMask_v0_3_1_补打加固_20261031/step_parts/arc_eye_side_barrier.step
3D打印文件/ArcMask_v0_3_1_补打加固_20261031/stl_fit_parts/arc_front_flat_lid.stl
3D打印文件/ArcMask_v0_3_1_补打加固_20261031/stl_fit_parts/arc_camera_edge_tray.stl
3D打印文件/ArcMask_v0_5_小振动盒与喇叭修正_20261101/step_parts/OPTIONAL_backplate_wire_port.step
3D打印文件/ArcMask_v0_3_1_补打加固_20261031/stl_fit_parts/arc_eye_side_barrier.stl
3D打印文件/ArcMask_v0_3_1_补打加固_20261031/stl_fit_parts/arc_imu_edge_keeper.stl
3D打印文件/ArcMask_v0_3_1_补打加固_20261031/stl_fit_parts/m2_fit_coupon.stl
3D打印文件/ArcMask_v0_3_1_补打加固_20261031/stl_fit_parts/haptic_left_pod_cover.stl
3D打印文件/ArcMask_v0_3_1_补打加固_20261031/step_parts/haptic_left_pod_cover.step
3D打印文件/ArcMask_v0_3_1_补打加固_20261031/stl_fit_parts/haptic_right_pod_body.stl
3D打印文件/ArcMask_v0_3_1_补打加固_20261031/step_parts/haptic_left_pod_body.step
3D打印文件/ArcMask_v0_3_1_补打加固_20261031/stl_fit_parts/wear_rear_occipital_cradle.stl
3D打印文件/ArcMask_v0_3_1_补打加固_20261031/step_parts/battery_only_tray.step
3D打印文件/ArcMask_v0_3_1_补打加固_20261031/step_parts/haptic_right_pod_body.step
3D打印文件/ArcMask_v0_3_1_补打加固_20261031/step_parts/arc_rigid_electronics_carrier.step
3D打印文件/ArcMask_v0_3_1_补打加固_20261031/step_parts/wear_removable_forehead_face_frame.step
3D打印文件/ArcMask_v0_3_1_补打加固_20261031/stl_fit_parts/haptic_right_pod_cover.stl
3D打印文件/ArcMask_v0_3_1_补打加固_20261031/step_parts/arc_structural_rim.step
3D打印文件/ArcMask_v0_3_1_补打加固_20261031/stl_fit_parts/speaker_strap_body.stl
3D打印文件/ArcMask_v0_3_1_补打加固_20261031/step_parts/arc_top_service_blank.step
3D打印文件/ArcMask_v0_3_1_补打加固_20261031/stl_fit_parts/speaker_strap_cover.stl
3D打印文件/ArcMask_v0_3_1_补打加固_20261031/step_parts/arc_camera_edge_keeper.step
3D打印文件/ArcMask_v0_3_1_补打加固_20261031/stl_fit_parts/wear_right_flat_connector.stl
3D打印文件/ArcMask_v0_3_1_补打加固_20261031/step_parts/wear_right_flat_connector.step
3D打印文件/ArcMask_v0_3_1_补打加固_20261031/stl_fit_parts/battery_only_cover.stl
3D打印文件/ArcMask_v0_4_B分体内架_20261031/stl_print/B01_common_frame.stl
3D打印文件/ArcMask_v0_4_B分体内架_20261031/stl_print/B02_mb_cradle.stl
3D打印文件/ArcMask_v0_4_B分体内架_20261031/stl_print/B03_camera_cradle.stl
3D打印文件/ArcMask_v0_4_B分体内架_20261031/stl_print/B04_imu_cradle.stl
3D打印文件/ArcMask_v0_4_B分体内架_20261031/stl_print/B05_camera_cap.stl
3D打印文件/ArcMask_v0_4_B分体内架_20261031/stl_print/B06_imu_keeper.stl
3D打印文件/ArcMask_v0_5_小振动盒与喇叭修正_20261101/step_parts/H03_nut_keeper.step
3D打印文件/ArcMask_v0_5_小振动盒与喇叭修正_20261101/stl_print/H01_body.stl
3D打印文件/ArcMask_v0_5_小振动盒与喇叭修正_20261101/stl_print/H02_cover.stl
3D打印文件/ArcMask_v0_5_小振动盒与喇叭修正_20261101/stl_print/H03_nut_keeper.stl
3D打印文件/ArcMask_v0_5_小振动盒与喇叭修正_20261101/stl_print/OPTIONAL_backplate_wire_port.stl
3D打印文件/ArcMask_v0_5_小振动盒与喇叭修正_20261101/stl_print/S01_body.stl
3D打印文件/ArcMask_v0_5_小振动盒与喇叭修正_20261101/stl_print/S02_cover.stl
3D打印文件/ArcMask_后枕托穿带修正_20261101/stl_print/R01_rear_cradle_clear_strap.stl
3D打印文件/RDKX5_B3_v0_1_分仓计算盒_20261102/stl/01_common_base.stl
3D打印文件/RDKX5_B3_v0_1_分仓计算盒_20261102/stl/02_compute_lid.stl
3D打印文件/RDKX5_B3_v0_1_分仓计算盒_20261102/stl/03_battery_lid.stl
3D打印文件/RDKX5_B3_v0_1_分仓计算盒_20261102/stl/04_x5_carrier.stl
3D打印文件/RDKX5_B3_v0_1_分仓计算盒_20261102/stl/05_left_service_panel.stl
3D打印文件/RDKX5_B3_v0_1_分仓计算盒_20261102/stl/06_right_service_panel.stl
3D打印文件/RDKX5_B3_v0_1_分仓计算盒_20261102/stl/07_front_service_panel.stl
3D打印文件/RDKX5_B3_v0_1_分仓计算盒_20261102/stl/08_waist_bridge.stl
3D打印文件/RDKX5_B3_v0_1_分仓计算盒_20261102/stl/09_second_bridge.stl
