Morechips/yuntong-smart-glasses/3D打印文件/ArcMask_v0_4_B分体内架_20261031/ASSEMBLY.md

# B分体内架：先装小座，再装整架

先断开电池和USB，仅做机械试合。按[六件认件图](images/02_part_identification.png)区分本体与支撑。尤其03的两侧宽桥、侧螺母窗、04的底托与长柱、05的两个上耳、01的两个开放线座均是本体，不能当支撑掰掉。

## 螺丝清单

长度按头下到尖端，非沉头。以下是本模型对应候选，使用手头螺丝时仍以实际头部/螺母和尖端余量试合。

| 位置 | 螺丝候选 | 数量 | 螺母先放哪里 | 方向 |
|---|---:|---:|---|---|
| 主板→02托架 | M2×12 | 4 | 02背面四个六角槽 | 从主板正面向托架背面 |
| 三个托座→01骨架 | M2×8 | 6 | 01背面六个六角槽 | 从托座正面向骨架 |
| 05压盖→03相机托座 | M2×8 | 2 | 03两侧窗口 | 从上侧向下 |
| 06限位条→04 IMU托座 | M2×16 | 2 | 04背面两处六角槽 | 从正面向后 |
| 01骨架→旧外圈 | 沿用旧4颗M2，原M2×8为候选 | 4旧 | 旧外圈原螺母位 | 沿用旧方向 |

新增合计：**M2×8八颗、M2×12四颗、M2×16两颗、M2普通六角螺母14颗**。骨架连接旧壳的4套另行复用，不包含在14套里。螺母井沿用名义对边4.2mm，并非热熔螺母孔；不要用烙铁压进来。头型候选空间Ø5×高3，超出的头型不能强装。

## 1. 清理与预装螺母

1. 只清03/04切片生成的局部支撑，逐点剪断，不拿整块支撑扭拉小座。
2. 01背面放6颗M2螺母；02背面放4颗；04背面放2颗。尚未接骨架前这些开口都可访问。
3. 03两侧小窗口各滑入1颗M2螺母，朝向对正。窗口只是装螺母，不塞热熔胶；若松可先用极少可移除胶带临时防掉，不能挡螺纹。

## 2. 主板小座

1. 带TF卡座和相机排线接口的一面朝前。四孔应自然对应32.6×32.6，PCB四角落在小承托面上，背面元件不顶住粗柱根。
2. 用4颗M2×12从主板正面穿到02背面螺母。先全数轻带入，再交替拧到贴合；不靠螺丝把PCB压弯。
3. 检查板下的USB、I2C/UART插头和线能自然退出，不要把引线卡在四柱与PCB之间。PWR/BOOT保持可按，USB线本轮非运行必需，但接口不能被硬顶。

## 3. 相机小座

1. 保持塑料8mm方底座，镜头向前，排线从托座上口退出。底面托在03小座中，边缘不压排线。
2. 底托预留约0.1mm薄定位层；若实物可直接稳定坐实，不强加胶带。若需要，使用薄双面定位层，避免厚泡棉、胶团或热熔胶垫高相机。
3. 05盖套过镜头，两个上耳落在03的硬限位台。盖子应自然落稳；不能落稳时先看底座/排线/定位层，不拧螺丝强压。
4. 从上侧用2颗M2×8向下锁入侧窗螺母。见[方向图](images/03_fasteners_camera_IMU.png)。这个步骤先在桌上完成；不从前面另塞两颗高头螺丝。
5. 镜头圆筒不被夹，排线没有折死角/被压住；轻触小座时相机不应在腔里晃动。图中的0.1薄定位层为名义预留，实物约2.2底座的公差尚未验。

## 4. IMU小座

1. PCB背面靠04底托，屏蔽罩朝前，弯针/杜邦头端朝外侧敞口。底托止于插针区之前，不把针脚垫在托面上。
2. 板背名义预留约0.1薄定位层，固定后应刚性、不晃；不靠厚泡棉悬空。
3. 06限位条跨在未插排针的约2.5mm侧边，主筋与宽片为防脱结构；不是压在金属罩上的压板。它不使用排针孔作螺孔。
4. 2颗M2×16从前向后锁到04背面的螺母。限位条先触到硬台，名义距PCB正面约0.2，不继续拧到把PCB压弯。检查条下焊盘/孔、罩体与针脚无硬顶。

## 5. 三个小座接共同骨架

主板座放左、相机座居中略上、IMU座放右。三个座各用2颗M2×8从正面锁到01背面预装螺母。没有用小座螺丝把错位的支架拉到位；每个安装台应自然贴合。相机与IMU因此连接同一个刚性骨架，不固定到可拆外观前盖上。

## 6. 原线束与开放线座

先保留已接好的原线束。按[三维理线示意](images/04_open_wire_seats.png)先实摆，留插拔和轻微松弧，再从侧面把线放入01的开放槽，用细扎带/线绳轻束止拉。4.2mm槽不是全部24AWG线的共同密闭通道；必要时分束沿骨架绕，不能靠盖板硬压。

相机FPC从上口松弧出，绕向主板；本轮只建宽6mm出口，不声称整条75mm标长均可拉直使用。60mm为保守预算，不是实测完整自由长度。紫线不是排线，也不是实际剪线长度。电池、喇叭及左右振动引线按现有侧出口布置，够不到的段先记录，暂不全剪断换线。

## 7. 装回旧外圈

使用旧四个X±66/Z±27安装点，将01固定到现有外圈。继续用原加固佩戴架/连接片/前后盖，不混用更早版本的盖孔。先让全部原线自然就位，确认相机/IMU不松动，最后轻合前后盖；盖板应自然贴合，不以螺丝强拉闭合。

这轮反馈只需指出：主板是否四角自然落座、相机/IMU是否晃或顶住、哪根线不够/哪个盖夹线。**不需要重测整套元器件或为核对再打印旧夹片。**
