Morechips/yuntong-smart-glasses/3D打印文件/ArcMask_v0_3_1_补打加固_20261031/ASSEMBLY.md

# 补打件装配与清支撑

## 先分清本体和支撑

- 左右连接片不需要支撑；背面的两块短方垫台都是本体，不能剪掉。
- 曲面架上的四个方形螺母座、两条额/脸之间的宽肋、顶带扣都是本体。
- 外圈检修窗旁的两条宽螺母承台及前端接顶壁的加固块都是本体；其它内架安装柱也保留，不是见到凸起就拆。
- 参照[实际CAD改动图](previews/06_补打改动与连接说明.png)。切片预览按线型区分模型/支撑；剪断树枝、逐点拆除，避免把大块支撑当把手扭拉本体。清理后的实体完整性仍需检查。

## 第1盘

1. 两张连接片：大平面贴床、两个短方台朝上；共四孔，靠近内侧的一列用于连接曲面架，外侧一列连接旧式外圈接口。左右镜像，不交换方台朝向。
2. 小盖：本次加宽版两孔中心距36mm，和旧32mm孔距不同；不要混装旧盖。
3. 外圈：先看检修窗两条承台/前端根部是否完整，再试M2螺母、原平盖与后隔板。小盖螺母从下方六角开口装入；应在安装主板/内架前完成，避免工具碰到电子件。

## 第2盘与四颗新螺丝

曲面架皮厚3mm，内侧/贴肤曲率未改。清理后检查鼻部两个开口端、两条宽桥筋、顶带扣与四个螺母座，无裂纹/分层再试合。

1. 先把4颗M2螺母放进曲面架朝前的四个六角孔，位置X±58/Z±25，名义口袋深2mm。
2. 左右连接片的两个短方台朝向曲面架，贴住架体的平安装台。使用内侧一列孔，从连接片平面一侧向架体拧入4颗新螺丝。
3. 名义M2×10候选：头座Y40、方台/架体接触Y45.5、螺母位Y45.5…47.5；实际垫片/螺钉长短与尖端不能碰软垫/头部仍要核对。只拧至贴合，不强行压弯曲面架。
4. 这四颗螺丝位于外圈与佩戴架之间，所以**先装好架体与连接片，再挂到外圈**，不是装上整机后再把螺丝塞进夹缝。
5. 最后利用外侧一列孔X±73/Z±26装到外圈；这四颗螺丝从佩戴架/后方一侧装入，头座Y43，方向与内侧新四颗相反。原孔位、耳厚3mm不变，但仍试螺钉长度和工具空间。

顶带、左右环带、后枕托、电池盒、振动舱与2209喇叭壳沿用。先空件装配、再实摆原线束，确认内架和插头不被承台或新架体顶住；不要求剪断全部线更换。没有真实头模型、压力或机械载荷验证，新件需从静态试装开始确认。
