Morechips/yuntong-smart-glasses/benchmarks/ground_tactile_joint_20261102/LIVE_20261102.md

# 真实图流：双模型能共跑，稳定性未过门

> 运行记录与核验原始文件位于原工作区的 `runs/` 和 `qa/` 目录，不随本包提供；下文以纯文本标注其路径。

2026-11-02。USB接回后ESP确认为COM20（303A:1001，序号90:70:69:FE:56:0C），按MAC在原RDK热点10.5.5.52发现；能力查询确认可调音量至70、马达可用、循环／功放关闭。应用ELF仍为`f6dd0c5dc0f97bd7e8610f5a7a9c14cb58a776e03c85b3889518b1d19a185310`。未刷固件、重启、改网络或发声振。

## 60秒真实双模型

原始摘要 `runs/live_20261102_155942_f61d2b/summary.json`／逐帧事件 `runs/live_20261102_155942_f61d2b/events.jsonl`／退出独立复查 `runs/live_20261102_155942_f61d2b/post_state.json`。真实ESP→电脑中继→X5两份原BIN→电脑决策，无GUI，声振关闭。

| 项目 | 实测 |
|---|---:|
| 收到JPEG／地面结果／盲道结果 | 702／667／139 |
| 接收至地面决策p95 | 78.00ms |
| 地面模型含读回p95 | 23.24ms |
| 盲道RPC p95（含板端前后处理与往返） | 50.50ms |
| 地面结果更新间隔p95／最大 | 172／1531ms |
| 更新间隔>500ms | 5次 |
| 图流重连／程序错误／声振回执 | 0／0／0 |

镜头朝天花板，地面全为UNKNOWN／insufficient_floor，盲道全为UNKNOWN／no_near_support。本轮只查运行与时序，不是地面场景完整后处理负载、识别准确率或佩戴纠偏验收；此前固定正样本也不能替代现场检查。

**p95达标不等于稳定通过。** 五次空档为1156～1531ms；下一帧接收年龄仍约47～78ms，没有对应秒级推理。帧序号连续、设备源帧戳只相差36～108ms，电脑接收间隔却超过1秒，指向采集／传输中的等待；不能据此单独归因无线、固件或电脑。

## 无模型图传对照

[只读脚本](check_camera_transport.py)先RDK直接读取ESP，再经原电脑SSH中继读取；不加载模型、不发执行器POST。两路不是同一份帧，不作严格吞吐改善对比。通过GET `/state`往返区间约束ESP与接收端的单调时钟偏移，计入毫秒量化，估算源帧戳年龄下界；不当作精确曝光到提示时延。

首轮读取超时 `runs/camera_20261102_160723_1b60f8/report.json`时未保存部分帧，原失败保留；补齐异常留存后复测 `runs/camera_20261102_160939_9bdd50/report.json`取得直接时序 `runs/camera_20261102_160939_9bdd50/rdk_direct.json`／中继时序 `runs/camera_20261102_160939_9bdd50/pc_relay.json`：

| 路径 | 结果 | 接收间隔p95／最大 | >500ms空档 | 源帧年龄下界>500ms |
|---|---|---:|---:|---:|
| RDK直接，目标30秒 | 38帧，9.71秒时超时 | 1331.68／1452.73ms | 3 | 10帧 |
| 电脑中继，约30秒 | 125帧，重连1次 | 1215.75／4219ms | 11 | 43帧 |

源帧年龄下界最大2766.86／2472.45ms，初始时钟查询往返398.43／110ms已计入保守界。**0.5秒接收后期限不能独自保证源帧足够新。** 候选生产路径目前仍按接收时间限输出，尚未补源帧时效门，诊断代码不等于修复。

无线只读状态 `runs/camera_20261102_160939_9bdd50/wireless_state.json`：信号约-37～-42dBm，AP信道6、power_save:on，接口计数未报errors／dropped。省电只是待验证线索，AP下作用和根因未确定，未临时或持久改变设置。`/stats`的stream_errors包含测试主动关闭客户端，停止后的累计fps也不能当运行FPS。

两类实验之间ESP启动ID由c2a6422a01d8a3794a896fae75936bc6变为26631e009b10b69addaca96ac7bb6936，原因未确认，不能说是自动重启／掉电；60秒共跑内部及第二次图传对照内部各自前后boot均一致，本代理未发复位／电源指令。

## 当前结论与后续

- 双BIN真实图流共跑60秒没有崩溃，但连续性门失败；无模型纯图传同样超时。保留独立候选，**不晋级原持续版**。
- 原126冻结文件未变，两RAM清理code=0、无残留目录。X5仍boot bc310612-0a65-4c12-8a31-00be4331989d，根／RAM rw、ext4错误0，无新增MMC／EXT4错误。此前存储故障仍仅暂未复现。
- 下一轮先排图传／采集阻塞，再验证源帧时效门；不靠放宽500ms期限、只报p95或隐藏UNKNOWN改善结论。无线省电可作带回退的单因素实验，需先明确改动范围，不能先写成根因。
- 用户要求识别与声振晚点测，当前不追加现场动作。真实地面／盲道、固定镜头／佩戴左右、新分工声振及长时稳定性继续待验。现有ESP接口够第一版，不为分工刷固件。

原19项软件检查 `runs/software_tests_final.txt`／9项窗口检查 `qa/viewer_check.json`保留；新增4项诊断时钟与失败判定检查 `runs/camera_timing_tests.txt`通过，不代表图传通过。见本轮核验 `qa/live_verification_20261102.json`。
