Morechips/yuntong-smart-glasses/benchmarks/ground_tactile_joint_20261102/README.md

# 地面避障＋盲道纠偏持续联调

> 运行记录与核验原始文件位于原工作区的 `runs/` 和 `qa/` 目录，不随本包提供；下文以纯文本标注其路径。

2026-11-03持续方式更新。**默认手动开始后运行至停止，语音／纠偏震动均取消累计3次上限。原冻结避障版不变，图传连续性与场景效果仍待完善。**

用户当前分工：障碍由语音提示；盲道跟随／纠偏由震动提示。原根启动入口和冻结126文件保持不变，不改变旧版马达含义。新逻辑只在本目录。

**A/B分级震动更新**：默认A（300ms、按轻中大每3／1.5／1秒），B改为200／350／500ms且保持同样周期；中心静默、方向3帧／等级2帧及回差，另有500ms／1.5秒节奏回退。57项软件检查和662次保存几何回放完成，见[新入口、参数与使用](HAPTIC_AB_20261103.md)。用户已断电休息，未追加实体测试或操作桌面；下次上电需关闭旧窗、重开新入口再切模式，实际手感待验。

**最新操作更正**：用户明确不要每轮3次限制，当前[持续版说明／新启动入口](CONTINUOUS_20261103.md)已替代下方限次操作。默认“持续”，开始后一直处理最新状态，停止／关闭才结束；仍按语音节流、震动间隔与过期保护工作。34项软件、11项窗口检查通过，旧窗口已正常关闭并重开新版。历史60／120秒和3次限制只记录当时验证设置，不是当前默认。

**11月3日本轮已收尾**：网线恢复，真实双模型120秒1427地面／306盲道、p95 78ms，但秒级空档与旧源帧仍失败；同输入缓存90秒／32图一致检查通过。候选中继退出路径修订后短复测清理正常，最终31软件检查，原126文件不改、零实体声振。用户要求先测完再补线，实机测试已停，见[完整结果与失败记录](RESULTS_20261103.md)／核验 `qa/validation_20261103.json`。仍不晋级持续版，先排图传与生产源帧时效，识别／佩戴另验。下方待网线／昨日停点是对应阶段历史。

**11月3日续验准备（网线恢复前历史）**：新增源帧时序跟踪和单／双／单静音对照，29项软件检查通过；ESP USB为COM20，但电脑有线网卡Disconnected，今日板测尚未开始，不能沿用昨日健康结论。等待网线恢复，见[本日停点与执行入口](VALIDATION_20261103.md)。扬声器线保持现状，本轮不发声振；原模型／固件／网络配置不改。

## 当前结果与停点

**USB接回后更正**：ESP已在线，能力与原应用身份匹配；60秒真实双模型702接收／667地面／139盲道，p95 78ms，但5次>500ms更新空档、最大1531ms。纯图传也超时，部分源帧戳过旧，接收后期限不能替代源帧时效。天花板画面全UNKNOWN，不验识别效果，见[实流与失败记录](LIVE_20261102.md)／本次核验 `qa/live_verification_20261102.json`。**保留候选不晋级，用户要求识别与声振晚点测。** 下方缓存与未回连是对应阶段历史。

用户手动重启后系统文件恢复可读；当前boot为`bc310612-0a65-4c12-8a31-00be4331989d`。最后只读复查 `runs/final_connection_20261102_151224.json`根／RAM为rw、ext4错误0、未见本次启动中的MMC读取／文件系统错误。此前UART确有`mmcblk1: recovery failed!`与sector 13633424 READ I/O错误，见原始串口 `../../hardware_test/rdk_x5_recovery/logs/uart_prompt_20261102_01.log`。**重启后暂未复现，根因未定，不代表存储故障已修好**；本轮未fsck／刷卡／改挂载或操作电源。启动日志里的供电属性查找消息和FAT未正常卸载警告仍保留，未当作新的扇区读取错误。

实际X5对照 `runs/board_20261102_142928_d75891/report.json`：同8份准备JPEG，单地面30秒，再双模型90秒；各自进程常驻，推理顺序调用，不是同时执行两个BPU前向。固定32图类别像素与量化模拟一致，同8图共跑时地面类别SHA保持一致，结束两份独立RAM目录清理code=0。

| 项目 | 地面单模型 | 加盲道模型 |
|---|---:|---:|
| 地面结果数 | 438 | 1230 |
| RPC＋地面决策p95 | 75.12ms | 80.66ms（增加5.54ms） |
| 地面结果更新间隔p95／最大 | 97／406ms | 141／422ms |
| 盲道结果数／有掩膜的结果数 | — | 238／55 |

盲道板端预测含前后处理p95为69.10ms，**不是纯BPU耗时**。缓存图的5个门均通过；这不包含真实ESP图传，不等于曝光到提示时延，也不证明识别准确率、动态纠偏或长期稳定性。较早15秒短测 `runs/board_20261102_142634_14086c/report.json`增加18.46ms、增量门失败，原始失败保留；90秒结果不能抹掉短时波动。

19项软件检查 `runs/software_tests_final.txt`与9项窗口生命周期检查 `qa/viewer_check.json`通过，包括重连换代重确认、停止、0.5秒过期清屏、串行反馈、错误停用与加载前存储保护；模拟图流／桩模型记录标为`TEST_ONLY`，不能作实机证据。新增健康复查在运行中每10秒执行，发现异常停止；退出复查并回收本次RAM目录。

**此前未回连状态已由上方实流更正。** 本轮无新增声振或刷ESP；现有接口足够第一版。先排图传连续性／源帧时效，再由用户就位验识别和限次声振。

## 旧限次窗口操作（历史；当前按上方持续版说明）

1. 双击根目录启动盲道避障联调候选.cmd `../../启动盲道避障联调候选.cmd`。打开后等待，默认语音／震动都关；原`启动地面避障演示.cmd`仍是旧功能。
2. 接好RDK供电、电脑网线，给ESP供电并让它接回原RDK热点。地址空白会按MAC查RDK WLAN；若ESP连电脑热点，填写它当前的HTTP图流地址。
3. 保持默认静音，选60或120秒，手动“开始检查”，在密码框输入X5密码。加载／模型一致性核对后显示结果；左侧是地面障碍，右侧是盲道自己的源帧，过期变UNKNOWN。配置在本轮锁定。
4. 静音效果看清后停止。准备在喇叭旁试听，可另开一轮勾“障碍语音55”；盲道震动还必须实际固定镜头朝前、核对佩戴左右再勾对应确认。每轮最多3句／3次500ms，不是新的持续佩戴版。
5. 点击“停止”或关闭窗口，会等待在途请求结束及RAM清理；已开始的一句语音播完、不追加。记录在`runs/live_*`，历史目录不删除。

窗口等待状态截图 `qa/viewer_idle.png`只验证界面；本轮核验与剩余项 `qa/reboot_verification_20261102.json`。旧阻塞时验收快照 `qa/verification.json`保留，状态以此处更新为准。

## 重启前的失败证据（历史，未覆盖原始记录）

- 16项本机检查 `runs/software_tests.txt`通过：图像偏位三帧确认、重复帧拒绝、换源／过期清除、多条盲道歧义、画面居中不振、姿态／佩戴左右待确认时不振、障碍／UNKNOWN优先、输出串行与失败不重发，共用回环JPEG图流的控制器重连和清理，以及系统I/O／只读挂载／ext4错误时不上传模型。
- 真实PC双ONNX检查 `runs/pc_20261102_125344_793c81/report.json`：8张独立准备图片，包含4张原地面开发图及4张历史盲道素材，后4张中2张有盲道掩膜；不报准确率，不当作X5 BIN或长时稳定性验证。`pair_00..07.jpg`是两份真实FP32输出，不是手工标注。
- X5网线最初未就绪，后端口可达但旧8秒握手失败；一次固定公钥握手约13.6秒并认证成功，命令仍超时。候选单独延长横幅／握手等待，原工具不改。
- 关键只读证据 `runs/connection_health_02.json`：固定公钥认证后，读取启动ID和Python健康命令均code=-1、stderr为`bash: /etc/bash.bashrc: Input/output error`。**停止继续加载模型／压板，未刷卡、修复文件系统、重启、断电或刷ESP。** 当前根挂载状态／错误计数未取得，不能沿用昨天rw／错误0；也不直接归因为SD物理损坏或供电。
- 首次尝试 `runs/board_20261102_124936_90f406/report.json`、第二次 `runs/board_20261102_125605_879cb2/report.json`、延长等待后的预检失败 `runs/board_20261102_125956_6cc821/report.json`均保留，不能当成BPU模型加载失败、量化失败或共跑通过；这些尝试未进入模型上传／推理阶段。

## 候选行为

1. 原地面BIN、原工作进程和通道决策只读复用。独立盲道进程用原GuideTWSI YOLO11n-seg 640 NV12 BIN，SHA256 `4c5150ce17c1e09264ffbadc20a0af84733be8c5edfbc579aded69f4f47b7439`；复用历史NumPy softmax兼容解码器，不安装依赖或重新量化。
2. 一路ESP图流，两模型当前顺序调用：先发布避障状态，再低频约3Hz运行盲道。模型各自常驻；盲道当前任务不能抢占，不承诺共跑无额外延迟。调用超过200ms会停用盲道分支并记录，不能用这个实验预算替代最终120ms时延门。
3. 每份结果绑定原始接收时间、设备boot／stream和连接代次。右侧盲道截图显示其自己的源帧，不把旧掩膜贴在新的原图上。结果有效期0.5秒，换源／断流清空。
4. 近端只有一个有纵向支持的盲道连通域时才估画面偏位；连续3个不同观察同向确认，进入阈值0.16／退出0.10（归一化图像偏位，非米）。缺少近端支持／多条候选歧义为UNKNOWN，不把提示点当转弯或盲道终点判断。
5. 画面盲道偏左→候选左马达提示朝左修正，偏右→右，居中→不振；**含义是图像内纠偏，不是已标定的身体航向／安全转向**。需镜头固定朝前、佩戴左右确认；现在两项都未现场验证。任何障碍、PENDING、地面UNKNOWN／过期都抑制盲道震动，不能靠盲道掩膜删掉障碍。
6. 障碍语音复用原七句／55，马达不再承担障碍方向；声振共用输出锁、最新单槽，能力查询后语音仍复核时效；500ms单脉冲／间隔至少1.5秒，失败停用、不重发。固件不能中断当前语音，所以语音播放期间暂不能发纠偏脉冲，不能称真正抢占。

## 命令行与后续验证

先只读确认系统可执行命令、固定公钥／boot、根和RAM挂载rw、ext4错误0；失败不加载模型。随后先固定图再静音实流，用户回来就位并核佩戴左右后，才限次验证声振。

```powershell
# 使用既有项目Python；密码只从标准输入进入内存，不放命令行或文件。
& ./.benchmark-venv/Scripts/python.exe benchmarks/ground_tactile_joint_20261102/check_joint_board.py --baseline-seconds 30 --seconds 90
# 输入已授权的X5 SSH密码；此命令不读取ESP或发送声振。

& ./.benchmark-venv/Scripts/python.exe benchmarks/ground_tactile_joint_20261102/live_joint.py --seconds 60
# 默认静音、不震动，按MAC从RDK WLAN发现ESP；PC热点路径可另给--url。
```

`live_joint.py`的语音／触觉必须显式开启，物理检查上限各1～3次；触觉还要求`--camera-fixed --mapping-confirmed`，这不是自动姿态验证。用户未准备好时不得代加这些参数。

板测门：同输入地面类别输出保持一致；接收至结果p95≤120ms、较旧版增加≤10ms，同时看有效地面结果更新间隔（暂定p95≤200ms、不得有>500ms间隙）、丢帧、正样本分割CPU耗时、两模型常驻资源及退出清理。缓存图RPC耗时不冒充实流接收延迟，更不是曝光到提示时延。若地面模型将盲道纹理当障碍，先记录冲突，不改旧掩膜放行；转头／身体方向／真正行走纠偏留待标定和现场素材。

## ESP接口范围

已有`POST /motor?channel=left|right|both&ms=20..500`、`POST /pcm?volume=0..70`和`GET /state`可承载第一版分工。新增的角色切换、确认、优先级、时效、限次及停止规则都在电脑候选端，**本轮不需要为此刷固件**。物理输出开启前先查询能力和循环状态；声音发送前仍在查询后复核时效。USB接回后能力已查询，未新增物理输出；实流连续性未过门。

后续可能需要的固件级语音打断／主动停止协议属于另一项改动，不能通过电脑调度假装已有。不要从本目录代码推断它们已实现。

旧验收快照 `qa/verification.json`记录首次I/O阻塞；本次更新另存重启后核验 `qa/reboot_verification_20261102.json`。候选现有独立窗口和根启动入口，未替换原演示窗口；旧窗口仍是原来的障碍声振含义，不能用它体验新分工。
