Morechips/yuntong-smart-glasses/benchmarks/ground_demo_20261101/README.md

# 地面演示主链路

当前提交版操作以 [使用说明](../../docs/USAGE.md) 为准，验证范围见 [状态](../../docs/STATUS.md)。

原文件相对位置保留，导出更改见 [整理记录](../../submission/EXPORT_CHANGES.md)。
