Morechips/yuntong-smart-glasses/benchmarks/ground_tactile_joint_20261102/CONTINUOUS_20261103.md

# 双模型持续联调

> 运行记录与核验原始文件位于原工作区的 `runs/` 和 `qa/` 目录，不随本包提供；下文以纯文本标注其路径。

**后续更正：** 已加入[盲道震动A/B分级](HAPTIC_AB_20261103.md)，默认A300ms、B200／350／500ms，按偏离改变周期；下方“单次500ms／1.5秒”是此前固定模式，现可在回退选项选择。持续至停止和无次数上限保持。用户已断电，本轮只完成软件验证，现场手感后测。

用户要求按持续使用方式试效果，取消原先每轮3句／3次及60／120秒的默认限制。**当前窗口默认持续运行，直到手动停止；声振不设累计次数上限。** 固定模型、两BIN与原阶段v0.1的126冻结文件不改。

## 使用

1. 打开启动双模型持续联调.cmd `../../启动双模型持续联调.cmd`。原候选入口仍可用，均进入新版“云瞳 · 双模型持续联调”。
2. “运行时长”默认“持续”；勾选需要的障碍语音55、盲道纠偏震动500ms。启用纠偏时仍确认镜头固定朝前、佩戴左右已核对。
3. 点“开始联调”。障碍持续存在时按间隔重复语音，盲道持续偏位且符合纠偏条件时按间隔重复短振，超过3次继续工作。
4. 点“停止”或关闭窗口后不追加提示；已开始的一句语音或单次震动结束后退出并清理本次RAM。界面显示已运行时间。60／120秒只保留为可选的定时诊断，默认不选。

本次重开已保留用户旧窗口中勾选的声振、镜头与左右确认选项，窗口等待手动开始，没有自动播放／短振。普通新启动仍不自动输出；不需要重刷ESP。独立马达连续短振工具只用于核硬件，联调时不同时运行它。

## 实现与保留行为

- `live_joint.py`默认`seconds=0`、`max_pulses=0`、`max_utterances=0`：0分别表示手动停止、无累计次数限制；循环允许持续运行。命令行仍可显式指定正的时长／次数用于自动回归，窗口始终传次数0。
- `GuidanceOutput`默认无累计次数限制，复用的`SpeechOutput`本就支持0表示不限；只改变默认配置，不改模型或方向决策。
- 单方向持续障碍语音约6秒一次，主要方向变化至少2秒；纠偏短振至少间隔1.5秒。声振共锁串行，只取最新状态，500ms以内单脉冲仍由ESP本地归零。
- 地面UNKNOWN／过期、障碍／待确认、盲道未确认或居中、换源／断流等仍抑制对应输出，不因持续模式放行；输出错误仍停用该输出，不排队重放旧提示。停止不打断固件已经开始的一句话。
- 沿用自动同地址重连、代次重新确认、每10秒健康检查、滚动4×8MiB事件／12张预览／2048条近期耗时／最多4096条诊断帧，持续运行不无限积累队列或日志。新的summary记录continuous、实际运行时间及配置上限。

## 验证与边界

34项软件检查 `qa/continuous_20261103/software_tests.txt`通过：声、振各模拟5次以上仍继续，直到Stop；0时长由外部停止事件结束，回环JPEG跨代重确认、过期清除与清理保持。11项窗口生命周期检查 `qa/continuous_20261103/viewer_check.json`确认默认持续、无声振次数限制、配置锁定和停止。软件输出为假接口／桩模型，不作新增实体声振验收。

旧窗口正常关闭后，新窗口已置前，显示“持续”，没有“最多3次”字样；未代点击开始。此前限次版源码备份在本轮source_before `qa/continuous_20261103/source_before`，历史报告不改写。此更正不影响原阶段v0.1启动器和模型资产。

**持续运行方式已具备，整机长期稳定性和识别效果仍按原证据范围。** 图传秒级空档、源帧时效门和场景泛化等尚未解决，详见[本轮板测](RESULTS_20261103.md)。不把取消人为次数／时长上限当成图传修复或正式验收通过。见本次核验 `qa/continuous_20261103/verification.json`。

## 操作方式更正

用户指出可用脚本完成的工作不应操作屏幕。以后本地程序的启动、停止、日志与状态核对优先脚本/API，界面留给用户自行观察和操作；不再为这些动作控制桌面。本次旧窗口切换已经结束，后续核验仅用脚本。
