Morechips/yuntong-smart-glasses/benchmarks/ground_tactile_joint_20261102/HAPTIC_AB_20261103.md

# 盲道纠偏震动A/B对比

> 运行记录与核验原始文件位于原工作区的 `runs/` 和 `qa/` 目录，不随本包提供；下文以纯文本标注其路径。

已实现三级偏离反馈，默认A，持续运行至手动停止、无累计触发次数上限。左右仍表示朝图像盲道所在侧修正；居中静默，障碍语音规则不变。**用户随后已将设备全部断电，本轮未追加板测、声振或桌面操作；A/B实际手感下次上电再验。**

## 入口与模式

下次上电后，先停止并关闭仍在运行的旧窗口，再打开启动盲道纠偏AB联调.cmd `../../启动盲道纠偏AB联调.cmd`。原“启动双模型持续联调”入口重开也会加载新代码；已运行的旧进程不会热更新，本轮未代重启或创建第二路图流。

“震动模式”在开始前选择、运行中锁定；停止后可换A/B。打开窗口不自动播放或震动，按需勾选声振、镜头朝前与佩戴左右确认，再点“开始联调”。

| 程度 | A：固定时长、改变快慢 | B：长短与快慢一起变化 |
|---|---|---|
| 居中 | 不振 | 不振 |
| 轻微 | 300ms，每3秒一次 | 200ms，每3秒一次 |
| 中等 | 300ms，每1.5秒一次 | 350ms，每1.5秒一次 |
| 明显 | 300ms，每1秒一次 | 500ms，每1秒一次 |

周期从本次开始量到下次开始，单次时长不额外叠入等待。语音／网络占用可以令实际间隔更长，不补发错过的节拍。第三个“回退”选项恢复500ms、1.5秒定长节奏；回退的是触觉模式，仍保留新的死区与确认规则。完整改动前源码另存备份 `qa/haptic_ab_20261103/source_before`。

## 偏离与确认

- 沿用`e=(近端盲道中心x−160)/160`，属于320像素输入的图像偏位，不是米或身体航向。
- 从静默开始，`|e|>0.16`同方向连续3个不同接收观察才确认；`|e|≤0.10`当帧停止追加。约为偏出26像素启动、回到16像素内停。
- 只有此前**已确认**的同侧纠偏可在`0.10<|e|≤0.16`继续，并立即用LOW档；尚在确认中的方向进入此带不能靠重复小偏位激活。跨到相反侧先停止旧方向，须越过相反侧0.16后重做3帧确认。
- 首次确认时：`|e|<0.30`为LOW，`0.30≤|e|<0.50`为MEDIUM，`|e|≥0.50`为HIGH。已有等级在边界加0.03处才升级、减0.03处才降级，连续2个新观察确认，允许直接跨档；实现边界比较含等号。方向待确认时等级NONE，不发纠偏。
- 丢失盲道／重复或倒序观察／换源／间隔超过0.5秒／过期都会清确认。地面障碍、待确认、UNKNOWN、源不一致、未确认佩戴等继续阻止纠偏；当前已开始的脉冲仍由ESP到时归零。

## 配置、接口与日志

`PathPolicy`增加`deviation_level=NONE/LOW/MEDIUM/HIGH`，原status／direction／offset保留。输出等级只在几何与方向有效时产生；界面显示“居中／轻微／中等／明显”，并区分待确认、未知。

调度器通过`haptic_profile`选择`cadence`（A）、`cadence_duration`（B）、`legacy`（回退）。原强制`pulse_ms=500`参数已从候选调用链移除，防止覆盖新模式。命令行示例：

```powershell
& ./.benchmark-venv/Scripts/python.exe benchmarks/ground_tactile_joint_20261102/live_joint.py --haptic-profile cadence
# 默认持续、声振关闭；需要测试时由用户显式选择开关／确认并启动。
```

每次获得共享输出锁后，重新读取最新floor／path状态，按当前档位与上次发送起点判断是否到期；没有脉冲任务队列。回执的通道／pulse_ms／final_level必须与请求一致且归零，否则停用输出、不重发。语音仍优先；其占用结束后不排旧提示。

haptic日志新增`haptic_profile`、`deviation_level`、`abs_offset`、`pulse_ms`、`period_s`、`cue_started_pc_monotonic`，保留请求ID、通道、时效与原始回执；运行配置和summary保存所选模式。正常停止／关闭、有界记录与持续模式保持。

## 本轮验证与后续

57项软件检查 `qa/haptic_ab_20261103/software_tests.txt`通过：10项偏离状态检查、10项模式／真实调度线程假HTTP检查、3项隐藏窗口检查，以及原有回环流、持续触发、输出互斥、时效／停止与预检回归。覆盖6种A/B实际请求、起点周期、回差／反向／跨档、声振超过3次、语音占用后的最新状态、错通道／时长／未归零和超时不重发。窗口测试仅创建隐藏的自有Tk对象，不操作用户桌面。

保存几何观测回放 `qa/haptic_ab_20261103/replay/replay_summary.json`：同一份662次历史盲道观测、107次有offset，重新确认得到LOW／MEDIUM／HIGH为13／14／22次，NONE613次。重算状态为UNKNOWN555／PENDING21／CONFIRMED86；这只是记录的几何回放，不重跑模型、不等于真实触发次数或准确率。A/B使用同一等级结果，仅模式映射不同，实体请求0。

原冻结126文件与模型／BIN／ESP固件未改，本轮不操作设备／网络／电源，不自动启用任何声振，见交付核验 `qa/haptic_ab_20261103/verification.json`。现有图传长空档、生产源帧时效门和场景泛化等限制仍见[此前板测](RESULTS_20261103.md)，本次不扩大验收。

下次用户站定、保持相同佩戴／地面场景，分别选择A和B，做居中→轻偏→中偏→明显偏离→回中，左右各看一次；核对方向、低档可察觉、大档更密、回中不追加。先用A，再停止切B，均手动决定结束；本轮已断电，此项与长时／行走效果留待现场反馈。
