Morechips/yuntong-smart-glasses/benchmarks/ground_tactile_joint_20261102/RESULTS_20261103.md

# 11月3日双模型板测与实流续验

> 运行记录与核验原始文件位于原工作区的 `runs/` 和 `qa/` 目录，不随本包提供；下文以纯文本标注其路径。

**两份原BIN共跑的处理能力通过固定图检查；真实图流仍有秒级空档／源帧过旧，不晋级持续版。** 本轮实机测试已停止，声振均关闭，用户可继续整理接线。原阶段v0.1的126冻结文件／根入口、两模型／固件／网络配置和供电控制不改。

## 连接与授权

用户说明ESP／RDK均上电、扬声器线尚未接妥；后补插网线并授权重试。电脑网口原Disconnected的[失败记录](VALIDATION_20261103.md)保留。恢复后预检 `runs/reconnect_20261103_183554.json`固定公钥正常、RDK boot `77c08a53-f3e7-47b4-9af8-2820b353aeca`，根／RAM rw、ext4错误0、无MMC／EXT4错误，ESP MAC对应10.5.5.52、应用ELF与原版一致、功放／循环关闭。

用户随后要求先测完本轮再补线；本轮不发语音／震动，不要求摆盲道，没有为无线排查改省电／热点、刷固件、重启或关机。当前镜头朝桌面键盘等近物，没有真实地面／盲道摆位，不能作识别或佩戴效果验收。

## 真实图流：单45秒／双120秒／单45秒

完整对照与各阶段目录 `runs/live_compare_20261103_183609_f1d751/report.json`。阶段为连续场景，输入帧不同；用于观察运行和时序，不能把p95差直接解释为同输入模型开销。

| 项目 | 单模型前段 | 双模型 | 单模型后段 |
|---|---:|---:|---:|
| JPEG接收／地面结果 | 464／455 | 1462／1427 | 544／531 |
| 盲道推理 | — | 306 | — |
| 接收至地面决策p95 | 63ms | 78ms | 63ms |
| 地面更新最大间隔 | 1672ms | 2032ms | 1312ms |
| 更新间隔>500ms | 3次 | 1次 | 2次 |

双模型120秒无推理异常／图流重连，盲道RPC含往返／前后处理p95为53.72ms。完整日志汇总更正：前单模型441 UNKNOWN／14 PENDING，双模型1425 UNKNOWN／2 PENDING，后单模型531 UNKNOWN；不是全部UNKNOWN。盲道306次均UNKNOWN，其中12次有非空掩膜但未达到近端支持；这不等于成功识别盲道，也不报准确率。单模型本身已经卡顿，不能将此现象全部归为新增盲道模型。

双模型阶段源帧戳年龄最大初始估计区间为2210～2289ms，已明显越过500ms。**接收后处理很快不代表收到的是新图。** 时钟方法为ESP状态GET往返区间约束初始偏移，源戳是固件标记的first-dma，并非独立曝光真值；恒定时钟偏移只是本短测的估计假设。

Windows项目Python的`monotonic`使用GetTickCount64、分辨率15.625ms，`perf_counter`为QPC／0.1微秒。后续诊断公式另把本地量化误差计入源帧年龄区间：上下界各再保守扩31.25ms，原报告不覆盖；即使扩界，本轮双模型最大年龄下界仍超过2.17秒，失败结论不变。63／78ms等接收时序也有量化，不能把15ms差当精确增量；下方固定图RPC用高分辨率计时。

## 退出异常与隔离候选修订

首轮最后单模型的45秒结果已经产生，但退出查询时出现Windows socket 10038、SSH session not active；退出时钟和健康查询失败，一个RAM目录清理未完成。该阶段**没有通过**，不能因已收到531个结果就隐藏退出失败。异常后独立复查 `runs/live_compare_20261103_183609_f1d751/recheck.json`仍同boot／rw／ext4错误0、无活动模型进程。核同boot、目录、模型SHA及无工作进程后，仅清理精确遗留目录 `runs/live_compare_20261103_183609_f1d751/cleanup_exact.json`，未触及SD卡。

候选新增[camera_link.py](camera_link.py)：仅对本地socket做select，SSH通道通过recv_ready轮询，避开Paramiko Channel.fileno在Windows创建的通知套接字；仍由所属处理线程关闭通道，沿用MAC发现／回环转发和有界退出。未改原中继文件或库。此改动针对可疑退出路径，**没有取得精确竞态堆栈，不能宣称唯一根因已证实或长期故障彻底解决**。退出时钟查询失败也会先保存部分源帧时序，避免再次丢诊断证据。

短复测20／60／20秒 `runs/live_compare_20261103_184546_c7e026/report.json`：地面结果228／673／218，双模型盲道152次；三阶段error与health_error均空，4个模型RAM清理均code=0，退出后还能完成能力／健康查询。末段有一条80端口ConnectionResetError(10054)转发记录，没有导致SSH失效／图流重连；保留，不写成所有转发错误均0。

短复测双模型仍有1125ms更新空档，源帧年龄下界最大约1391ms（量化扩界后仍>1359ms），整链门继续失败。前后短单模型段虽无>500ms更新空档，但源帧年龄上界分别约544／534ms，不能据此宣称已足够新；这些上界并不等于已证明真实年龄超时。新中继未解决图传长空档。

## 排除无线的同输入板端对照

同8份准备JPEG，单30秒／双90秒报告 `runs/board_20261103_184319_0687df/report.json`。独立RAM里的两个工作进程常驻、顺序调用；不是两个BPU前向同时执行，也不是纯BPU耗时。

| 项目 | 单地面 | 双模型 |
|---|---:|---:|
| 地面结果 | 441 | 1301 |
| JPEG RPC＋地面决策p95 | 64.27ms | 63.46ms |
| 更新间隔p95／最大 | 94／359ms | 125／406ms |
| 盲道结果／非空掩膜 | — | 236／54 |

固定32图与量化模拟类别像素一致1.0，同8图共跑前后地面类别SHA一致；5个缓存时序门通过，盲道板端预测含前后处理p95为51.79ms。两模型清理code=0、全程系统健康未变。单／双约0.81ms差属于本次样本波动，不称新增模型反而加速。此处包含真实非空盲道解码与地面候选负载，仍不等于独立识别准确率或真实采集至提示时延。

## 收尾与后续

最终只读状态 `runs/final_state_20261103_1850.json`：同RDK boot、根／RAM rw、ext4错误0、无MMC／EXT4错误，约62℃；模型进程／RAM遗留为空。ESP boot全程为248827d06b1ee90b1a2c61e90b884fe2、功放／循环关闭，固件未改。所有本次测试进程退出，设备保持上电；旧存储I/O问题仍只是本次暂未复现，根因未定。

31项最终软件检查 `runs/software_tests_20261103_final31.txt`包含禁止SSH Channel.fileno的本机真实socket验证、回环JPEG桩模型重连停止、时钟量化和连续性门；不是31项实物验收。生产源帧时效门尚未补，当前仍不能用接收后500ms保证源图足够新。诊断公式最终扩界发生在本轮采集后，仅离线检查，不冒充重跑板测，原始报告保留。

当前判断：**保留双模型方向，不因图传卡顿立即换模型；先处理采集／发送／无线／TCP等待和源帧时效。** 装壳／天线、省电、干扰、供电仍待有控制的证据，不能从信号强或一次卡顿判定根因。接线完成后，识别／纠偏／声振另约限次现场检查；本轮不追加硬件实验，不晋级原持续版。见本轮核验 `qa/validation_20261103.json`。
