Morechips/yuntong-smart-glasses/benchmarks/ground_tactile_joint_20261102/VALIDATION_20261103.md

# 11月3日续验准备与连接停点

> 运行记录与核验原始文件位于原工作区的 `runs/` 和 `qa/` 目录，不随本包提供；下文以纯文本标注其路径。

**后续更正：** 用户补网线后实际完成本轮续验并已停止实机测试，结果见[完整报告](RESULTS_20261103.md)。下方为恢复前准备与连接失败历史，原证据保留。

用户要求继续验证双模型，说明ESP／RDK均已上电、扬声器线接触未妥，本轮保持线束现状，语音和震动关闭。原阶段v0.1入口与126冻结文件不改，不操作固件、热点或电源。

## 当前设备证据

- ESP USB枚举为COM20，VID:PID 303A:1001，序号90:70:69:FE:56:0C；只确认USB身份，不能替代无线在线或本次固件运行检查。
- SSH初次连接 `runs/preflight_20261103_181255.json`拒绝；有线网卡状态 `runs/network_20261103_1818.json`为Disconnected／0bps，电脑地址仍192.168.127.200/24。已请求用户重新插紧RDK到电脑的网线，等待物理链路。
- 没有取得今天的RDK boot／挂载／ext4错误或ESP无线能力，不能沿用11月2日的健康结果。未上传／加载模型、未开始真实图流或发声振。

## 本地新增验证能力

- `live_joint.py --trace-transport`可记录同一轮每个接收帧的源帧戳／接收时间与启动前后ESP时钟GET区间，保存`transport_trace.json`。限4096帧，统计说明窗口范围；记录接收空档、源帧年龄上下界、无效源时间头，地面更新空档次数／全轮最大、盲道有掩膜次数也独立统计。未加该参数时原候选路径保持；这些是诊断，**未改模型决策或补生产源帧时效门**。
- [单／双／单对照入口](check_live_comparison.py)按默认45／120／45秒连续静音运行，保存每轮摘要、源代码快照和门限；中间双模型，前后地面单模型。帧是连续场景，不是同一份输入，所以增量只作描述，不能替代已有固定图同输入板测。
- 门限分别看接收至决策p95≤120ms、全轮更新／接收间隔≤500ms、源帧年龄上界≤500ms、源头有效且采样覆盖全体接收帧、零重连／异常／实体声振。缺失时钟／样本、源帧过旧或长空档不能被低p95掩盖。接口GET的时钟区间是估计，不是独立曝光真值；本轮准备不宣称它已有生产安全效力。
- 29项软件检查 `runs/software_tests_20261103_final.txt`通过，涵盖真实控制器＋回环JPEG＋桩模型、时钟估计、失败门与旧时效策略；均不作今日板端／识别／声振验收。模型、BIN、固件、阈值未改。历史QA与失败记录原样保留。

## 网线恢复后执行

先按固定公钥只读确认RDK系统可读、根和RAM为rw、ext4计数存在且为0、无MMC／EXT4错误，再查询ESP MAC／固件／功放与循环状态。异常停止，不修改存储或重启。

```powershell
& ./.benchmark-venv/Scripts/python.exe benchmarks/ground_tactile_joint_20261102/check_live_comparison.py --baseline-seconds 45 --seconds 120
# 从标准输入输入X5密码；不带任何声振参数。
```

先看实际镜头，不把未摆位场景当成识别验收。只做运行稳定性，无需接好扬声器；如需地面／盲道效果或物理纠偏，提前告知用户并等待就位。装壳／天线影响尚无开合盖对照，不能当作已确认根因。当前双模型仅为隔离候选，未晋级原持续版。
