Morechips/yuntong-smart-glasses/3D打印文件/RDKX5_B3_v0_1_分仓计算盒_20261102/qa/建模修订说明.md

# 数字检查与修订范围

- 初轮数字检查发现底座/分体侧板重复占体积、横框与盖柱交叠，以及垫片/普通螺母被边板挤占。改为留0.15mm装配座间隙，并做侧板内侧局部螺母避让；不改变官方X5几何。
- 后续检查定位到横框后部焊盘连接筋与盖柱重叠，去掉多余连接筋，保留连续主梁；上层模块最终位置和几个竖向装入位置重新检查。
- 最终533项数字几何检查通过；九个STL均闭合、法向一致、单连通体、与CAD体积误差<0.8%、已平放且单件包络适合256mm打印板。
- 用户本地M2.5铜柱未到，接受M3×8贯通双通铜柱作套筒、M2×16螺丝贯穿/M2螺母锁紧。单独396项避让检查通过，打印几何不变、不扩X5孔。实际铜柱需满足8mm柱身、对边≤5.5、M2杆能自由贯通，仍待实配。
- 九件原网格按3mm间距合一盘，A1/PETG离线切片完成。实际3MF/G-code核对所有九件切出、原网格无缩放/误摆、无越床、无支撑挤出；仅延时摄影兼容提示。预测47272秒/170.46g，非实际打印结果。
- 首次受限环境启动Bambu CLI失败、无切片输出；允许软件必要缓存后，同一离线命令成功。未连接打印机/开发板，无打印提交或电气动作。
- 自动交互浏览器检查因工具运行环境无法初始化而未完成；HTML已生成，交互按钮未作GUI验收。CAD静态图已目视检查，不以此代替实装、工具可达/原线弯曲、承载或热验证。
