Morechips/yuntong-smart-glasses/benchmarks/ground_route_screen_20261031/runs/round01/data/development/A01_03.jpg

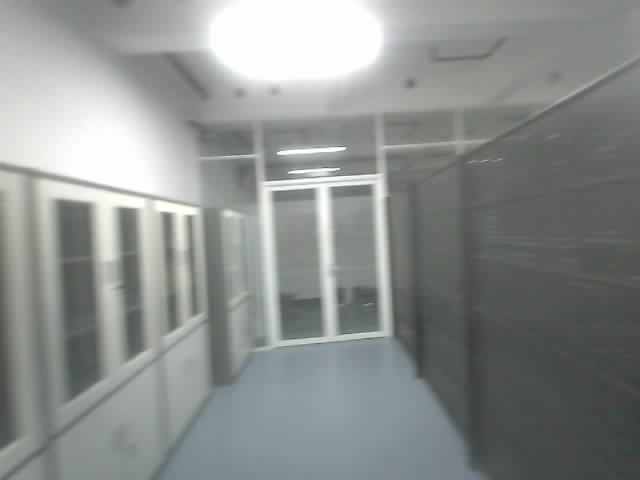
benchmarks/ground_route_screen_20261031/runs/round01/data/development/A01_03.jpg
