Morechips/yuntong-smart-glasses/benchmarks/ground_route_screen_20261031/runs/round01/data/development/A07_02.jpg

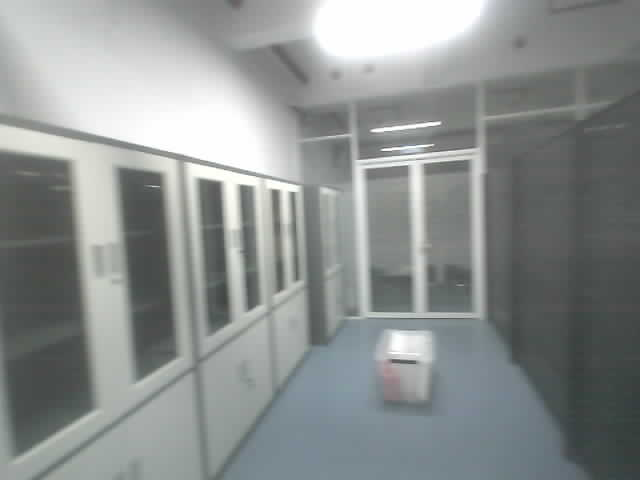
benchmarks/ground_route_screen_20261031/runs/round01/data/development/A07_02.jpg
