Morechips/yuntong-smart-glasses/benchmarks/ground_route_screen_20261031/runs/round02_20261101/coarse_labels/A01_02.png

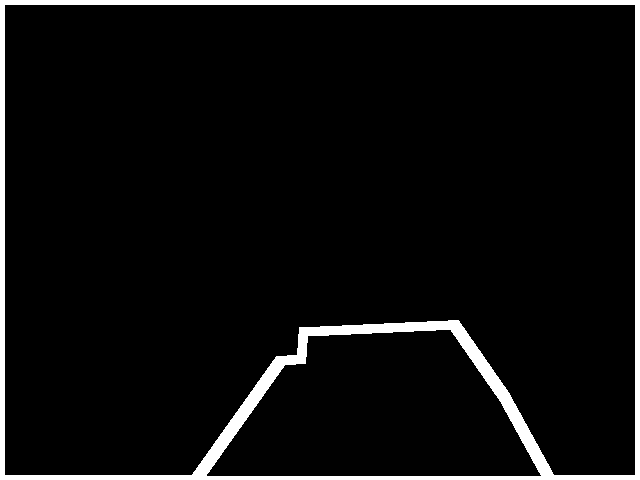
benchmarks/ground_route_screen_20261031/runs/round02_20261101/coarse_labels/A01_02.png
