Morechips/yuntong-smart-glasses/submission/EXPORT_CHANGES.md

# 整理改动

## 2026-11-03 提交范围更正

按用户补充要求，移除建模生成脚本、参数与CAD环境说明；保留STEP/STL/3MF、可旋转模型、图示和装配说明。软件与ESP源码仍保留，原工作区的建模源码不删除。

仅修改导出副本，不覆盖原工程。主模型、BIN、WAV 和制造几何均按原字节复制；详细哈希见清单。

1. 新增面向提交的 README、安装 / 使用 / 装配 / 状态文档、离线入口和静态核验。
2. SSH 主机、用户、指纹和 ESP MAC 改读忽略的本地配置，仍校验可信公钥；没有保存密码。
3. 新根启动器使用本仓库环境，默认关闭语音 / 触觉且等待开始；原工作区入口与模型不改。
4. 候选改校验本包主链路清单；外部盲道模型和照片未附带。候选仍未晋级。
5. 固件移入 firmware/esp32s3，保留当前 main 和板级组件；合并重建配置并清空 Wi-Fi 密码。未复制已编译固件或托管依赖，未重新构建。
6. 模型数据只保留已使用的 32 张开发图、相关粗标与模型，独立保留场景不导出。
7. 建模保留当前五个模块版本及其中历史替换件供追溯；组合表优先。省略工作区交付门 / 历史切片启动器，未收录历史引用转为明确文字提示。
8. 自有代码未擅自指定开源许可证；上游授权独立保留。个人材料、原始采集、日志和本机工具环境不导出。

复制来源与变换前后哈希见 PROVENANCE.json，未收录历史引用见 omitted_references.json。

文本换行已对齐 Git 属性：CMD/PowerShell 为 CRLF，其余文本 LF，清理空白行尾和多余文件尾空行；模型和制造几何保持原字节。
